evolutek/carte-mat-de-balise/V3/Board.pdf

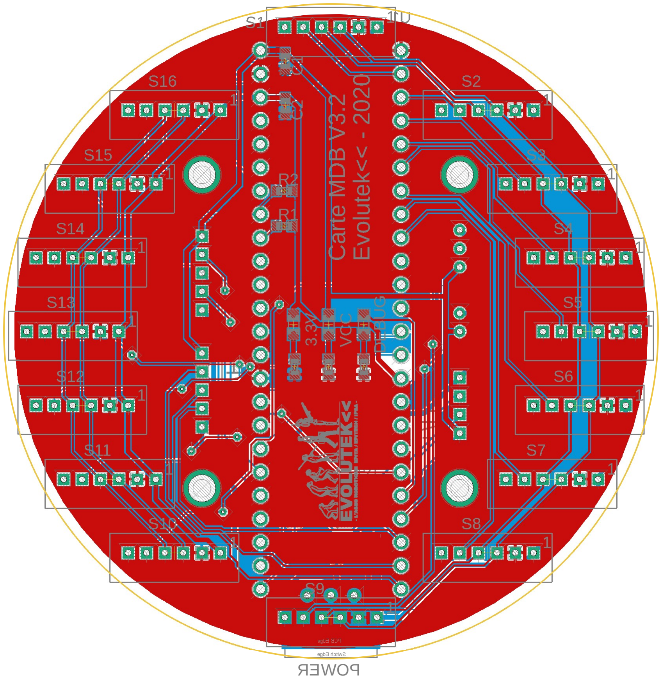
[picture p1: figure]

03/09/2020 21:59 C:\Users\coren\Documents\carte-mat-de-balise\V3\Board.brd
