evolutek/carte-mat-de-balise/V5/Mapping STM32.PNG

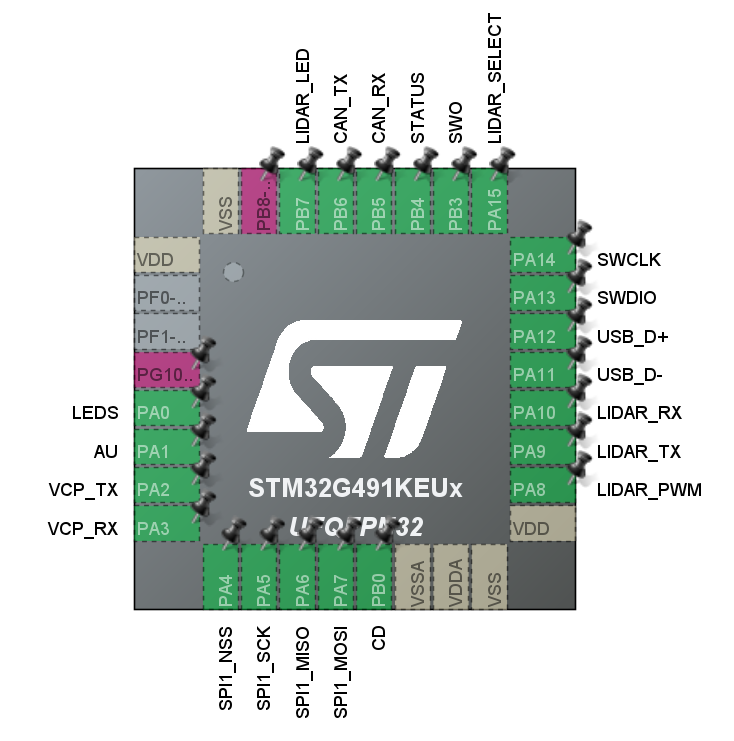
V5/Mapping STM32.PNG
