evolutek/carte-mat-de-balise/Carte Led V1/Output/carte-led.step

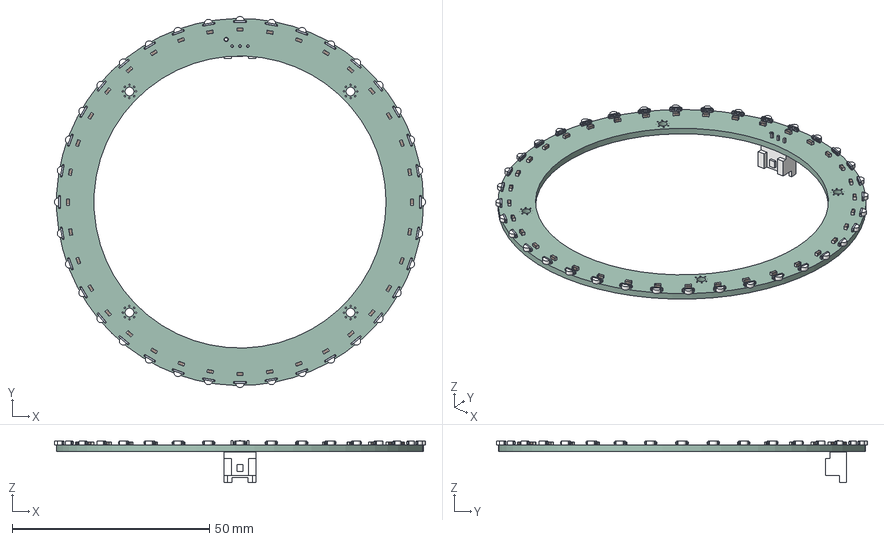
[picture p3: CAD file, 2024-11-06]
Carte Led V1/Output/carte-led.step
94.0 x 94.0 x 10.7 mm
_autosave-carte-led PCB
