evolutek/carte-mat-de-balise/V2/Board.step

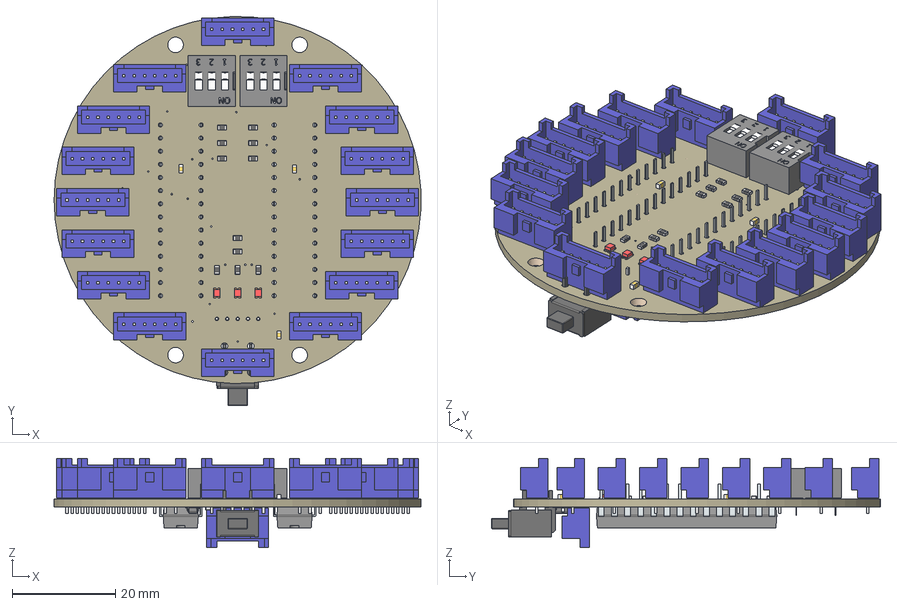
[picture p4: CAD file, 2020-03-29, an earlier design]
V2/Board.step
70.9 x 75.2 x 17.3 mm
Board
CHIPLED_0805 x 3
10k x 12
JST6 x 16
JST5
EDG-03 x 2
PinsArrayLR x 2
100nF x 3
FDV303N
