evolutek/carte-mat-de-balise/(threads)

Thread 6 (2024-12-05):

Développement SW

TheCrabe, 2024-12-05:
- [x] Send request
- [x] Read Descriptor (polling)
- [ ] Read Descriptor (interrupt)
- [ ] Read Descriptor (DMA)
- [ ] Continuous scan reading (polling)
- [ ] Continuous scan reading (interrupt)
- [ ] Continuous scan reading (DMA)

TheCrabe, 2025-02-13:
Polling does not working with this use case

Closed 2025-04-12.
