evolutek/carte-mat-de-balise/V5/Output/Schematics.pdf

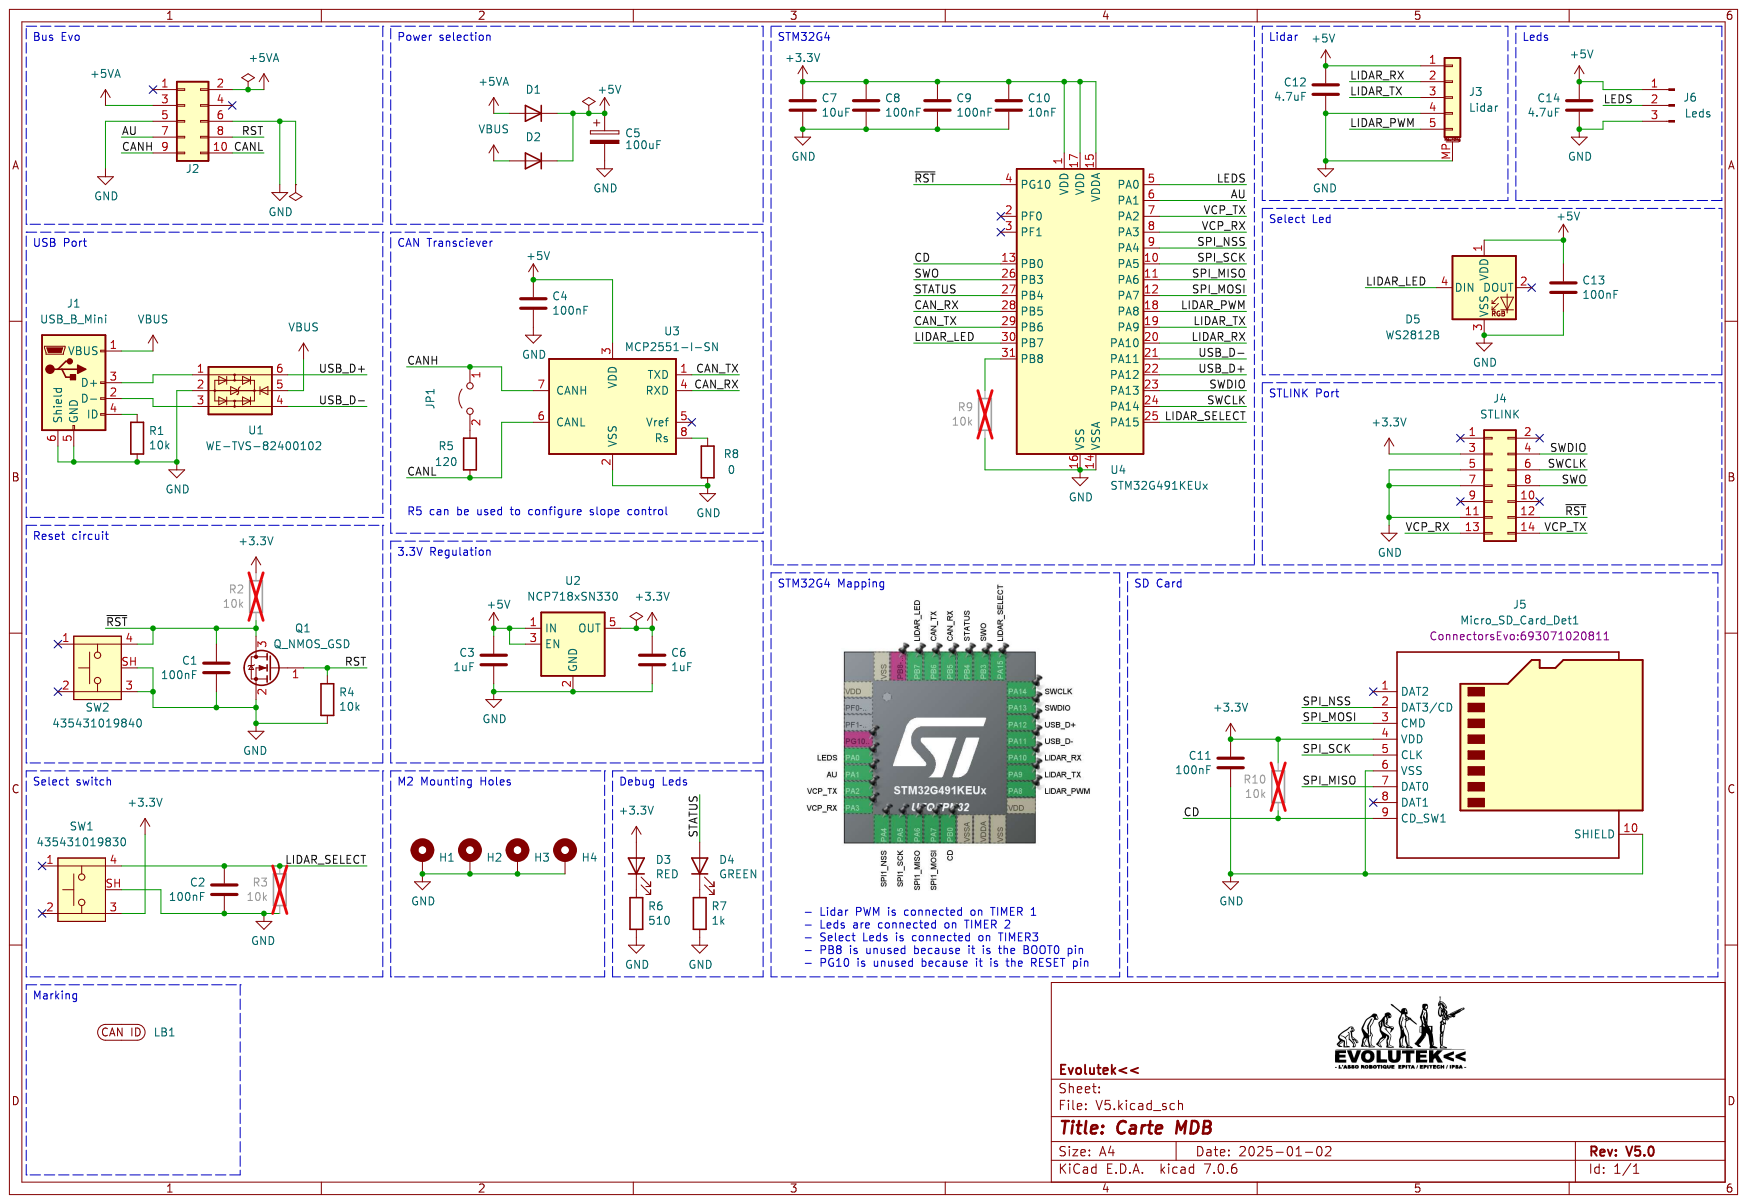
[picture p5: page 1]
