evolutek/carte-mat-de-balise/V5/Output/Board-Front.pdf

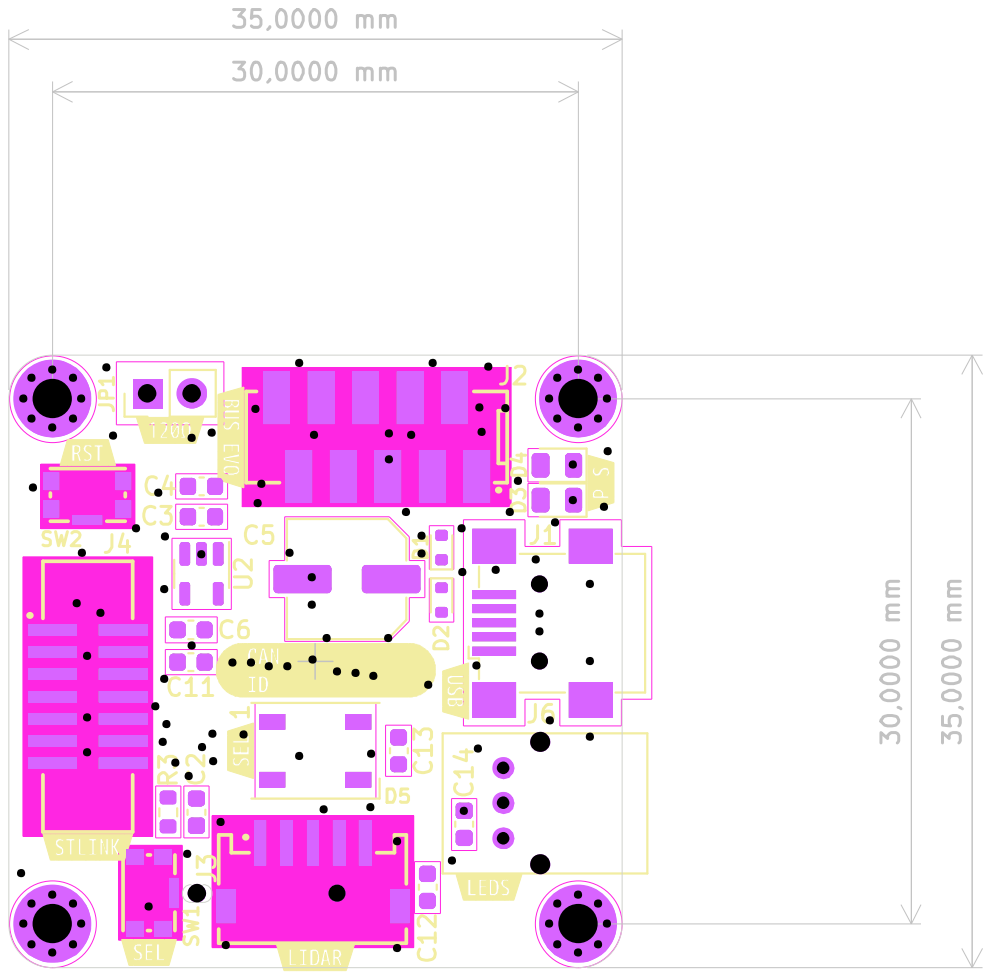
[picture p6: page 1]
