evolutek/carte-mat-de-balise/V5/Output/Board-Back.pdf

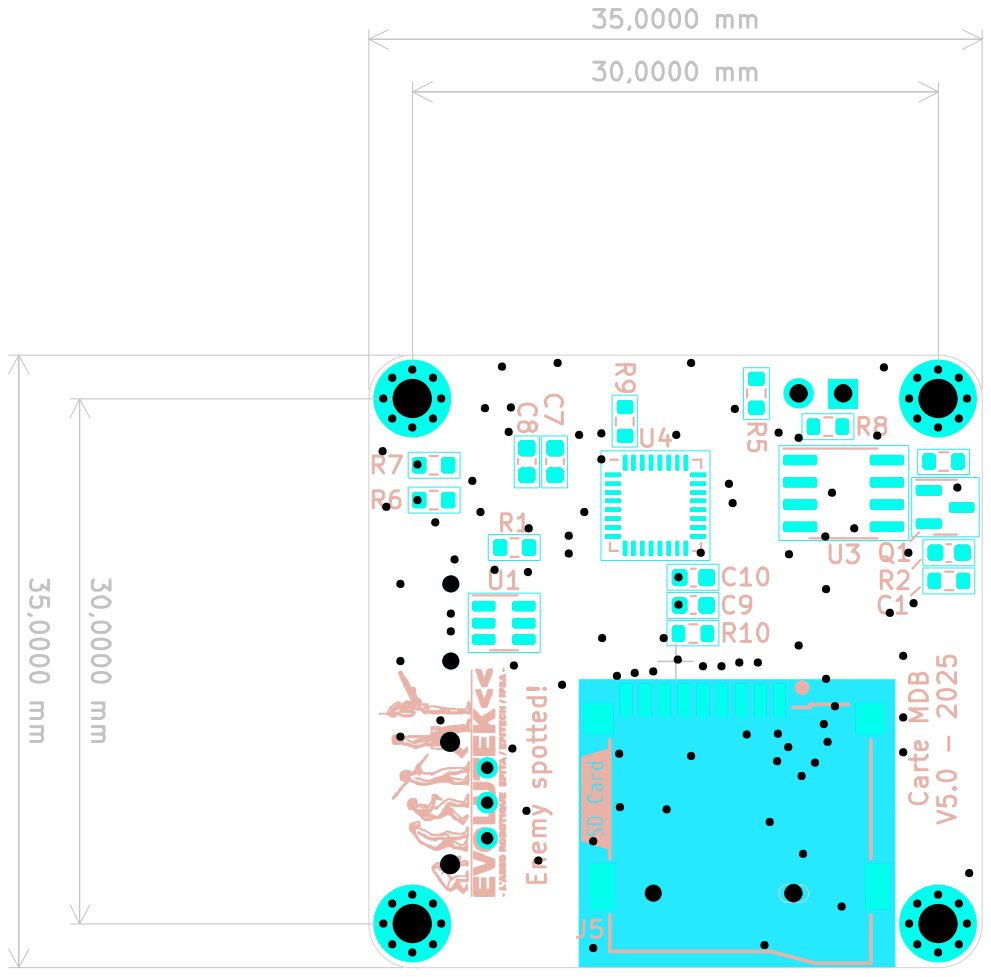
[picture p7: page 1]
