evolutek/carte-mat-de-balise/V3/Schematics.pdf

03/09/2020 21:59 C:\Users\coren\Documents\carte-mat-de-balise\V3\Board.sch (Sheet: 1/1) | JST6 GND | JST6 GND | JST6 GND | JST6 GND JST6 GND | JST6 GND | JST6 GND | JST6 GND JST6 GND | JST6 GND | JST6 GND | JST6 GND JST6 GND | JST6 GND | JST6 GND | JST6 GND

+3V34.7k

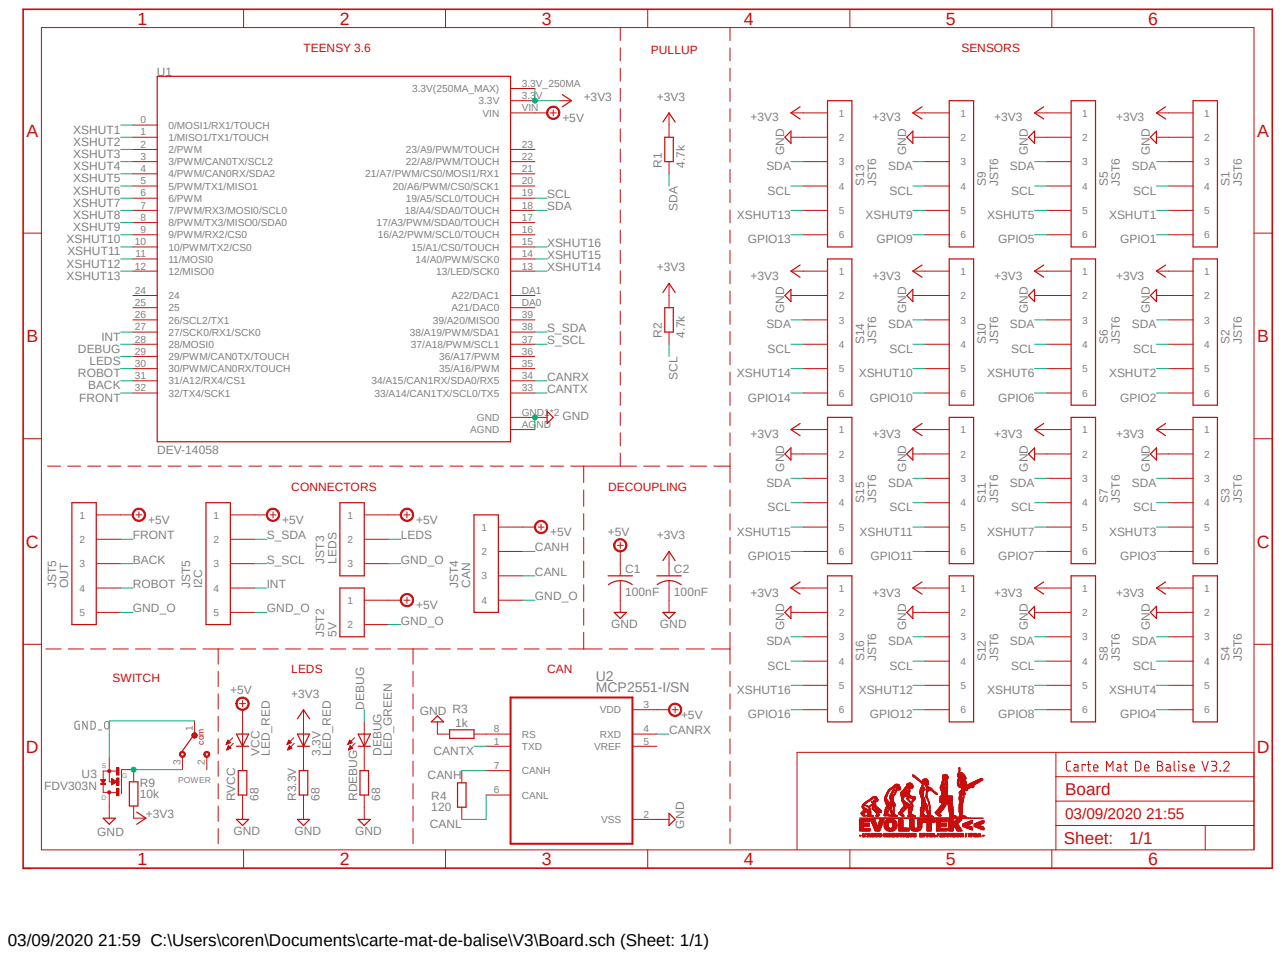
[picture p8: page 1]
