evolutek/carte-mat-de-balise/V2/Schematics.pdf

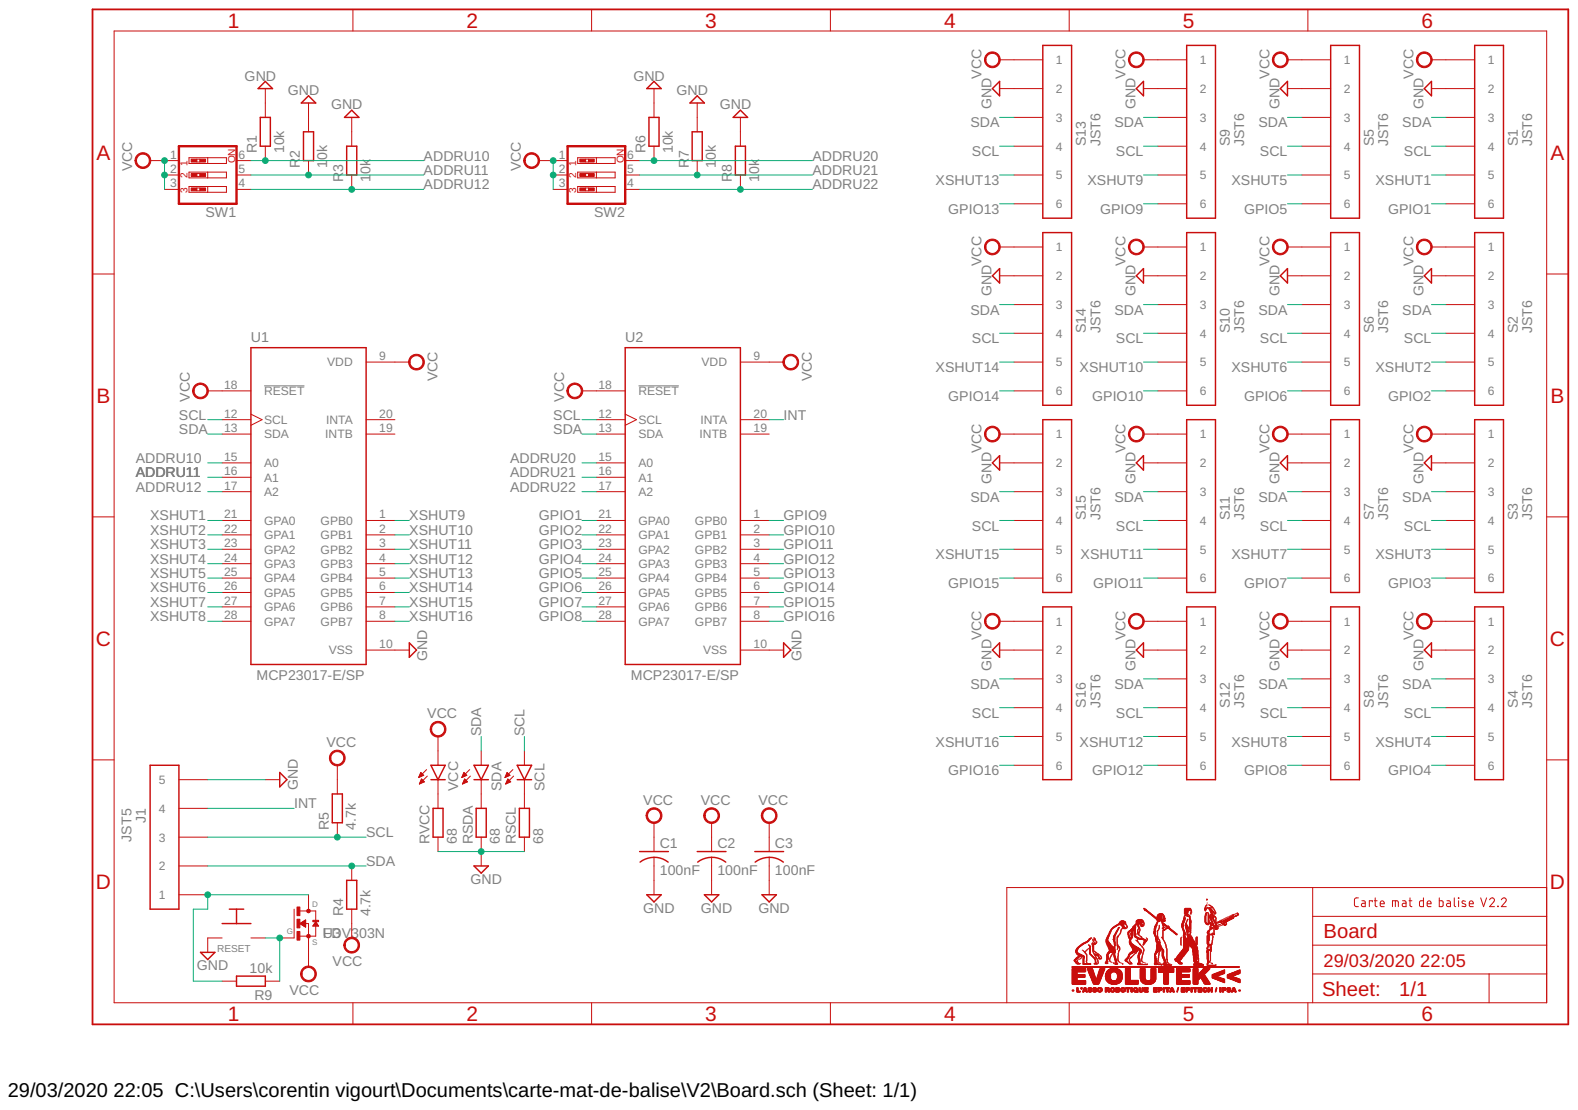
[picture p9: page 1]

VCC VCC

29/03/2020 22:05 C:\Users\corentin vigourt\Documents\carte-mat-de-balise\V2\Board.sch (Sheet: 1/1)
