evolutek/carte-mat-de-balise/Carte Led V1/Output/Schematics.pdf

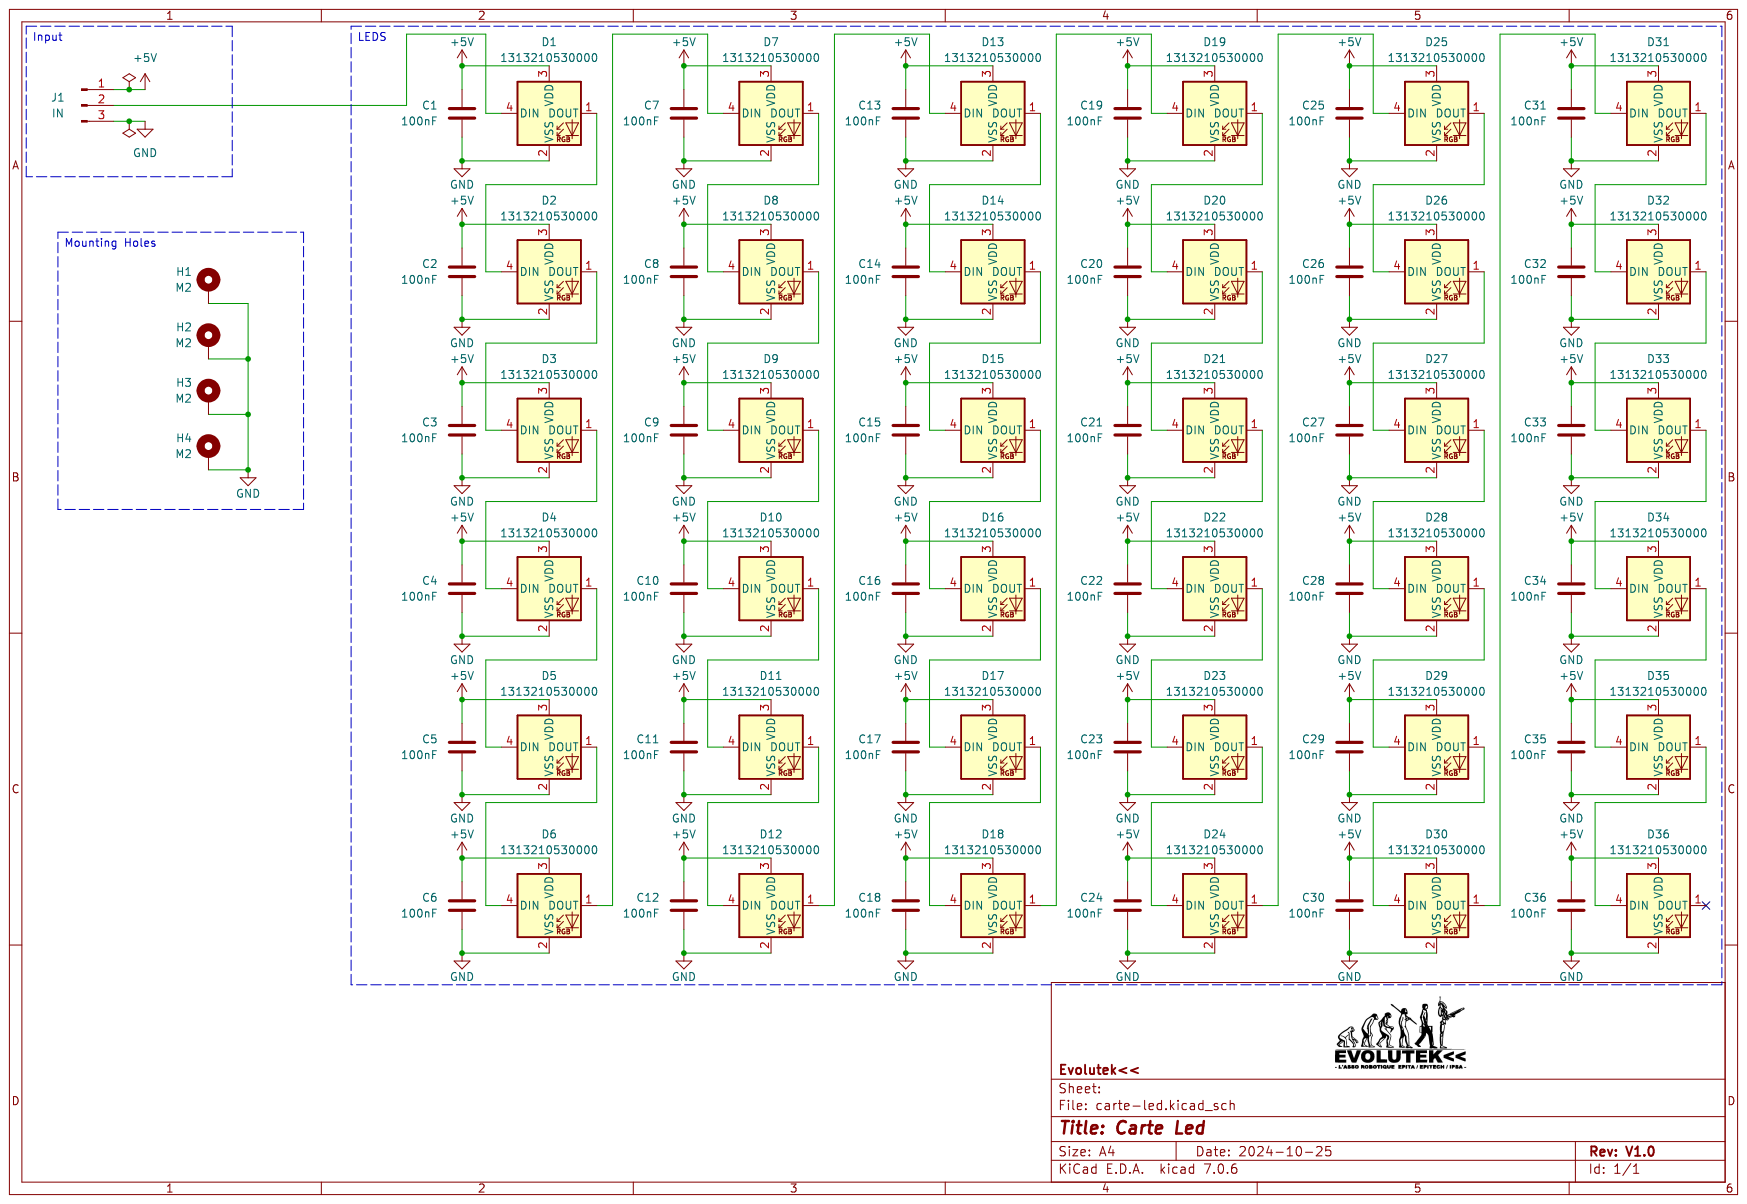
[picture p10: page 1]
