evolutek/carte-mat-de-balise/V4/Output/Schematics.pdf

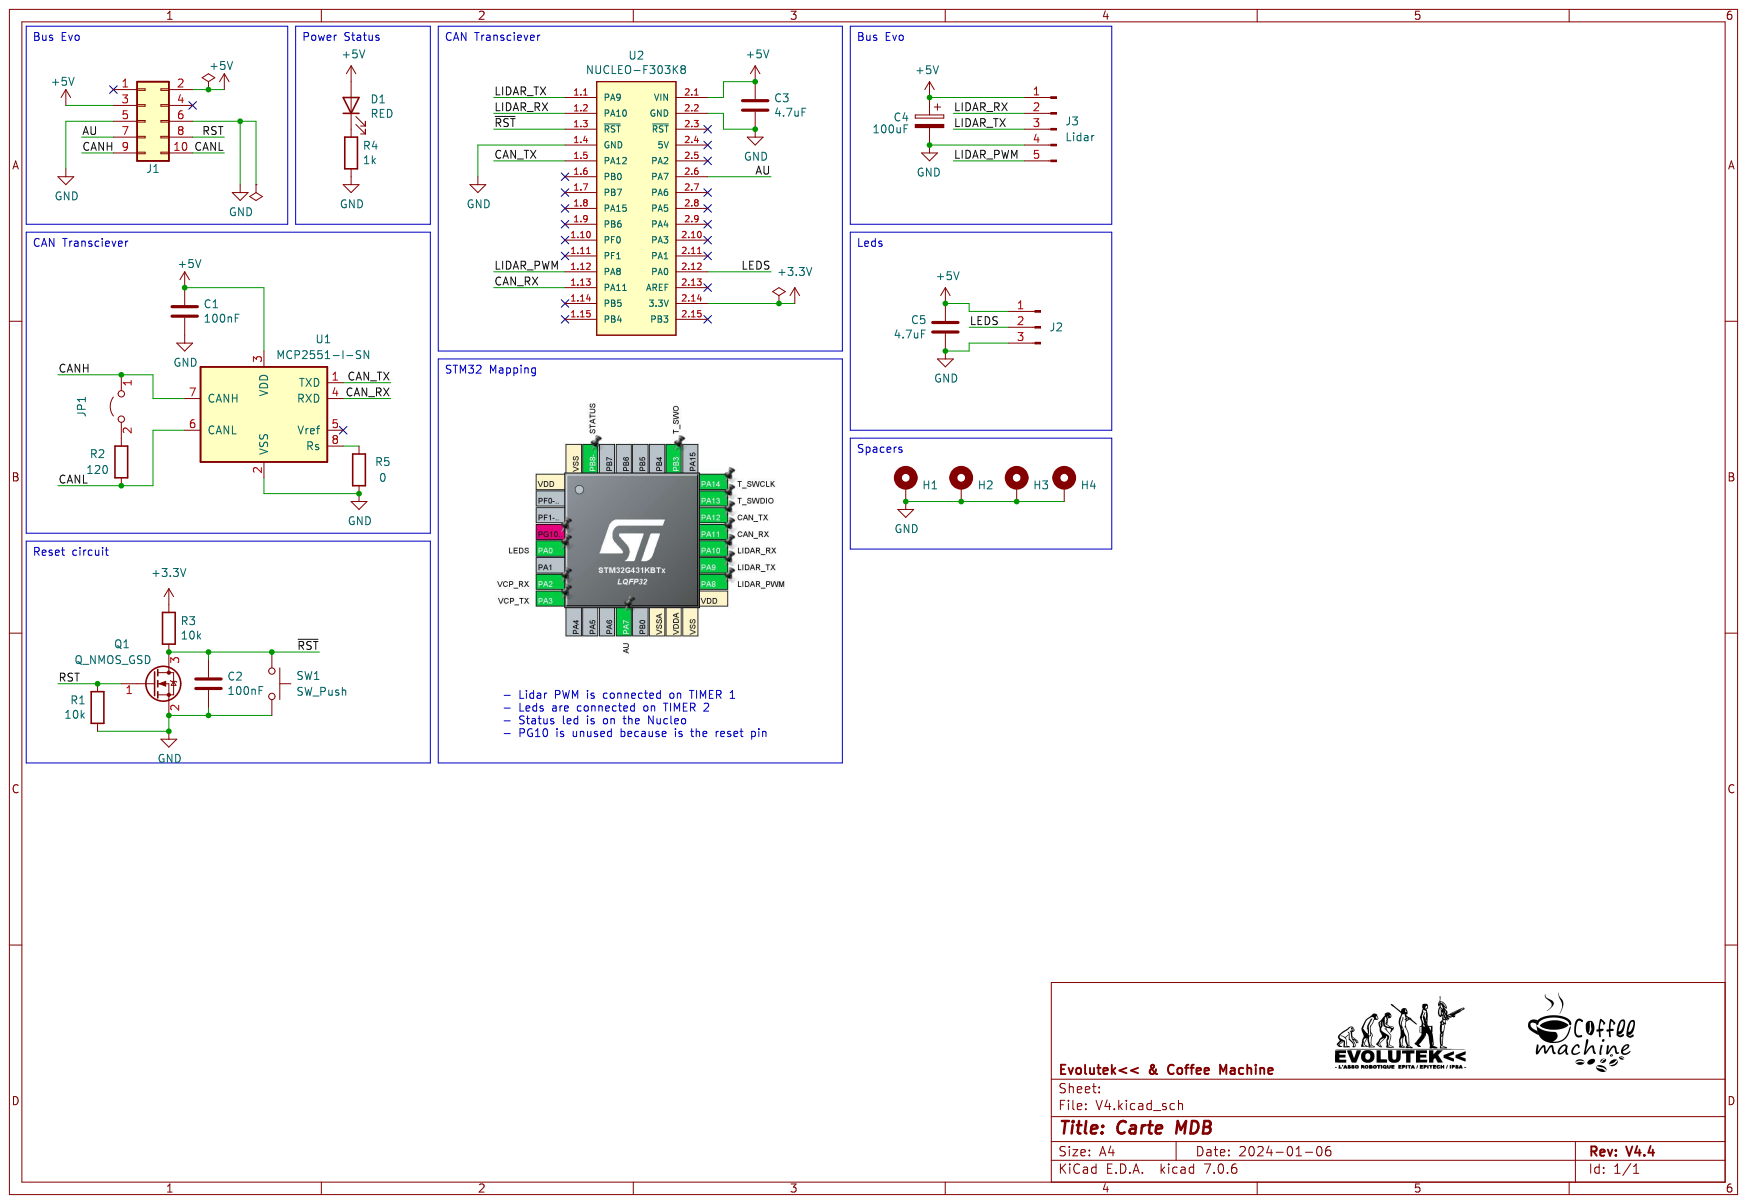
[picture p11: page 1]
