evolutek/carte-mat-de-balise/Carte Led V1/Output/Board-Front.pdf

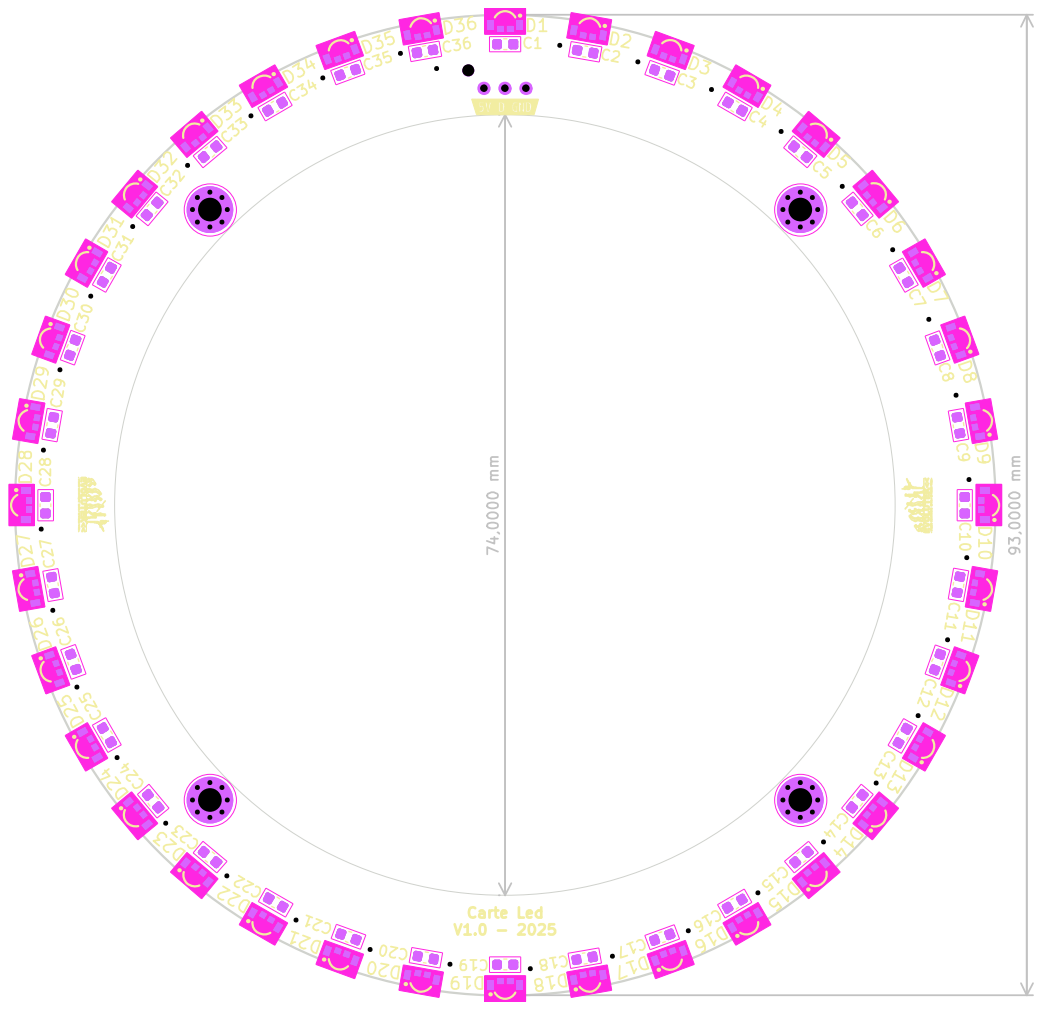
[picture p12: page 1]
