evolutek/carte-mat-de-balise/V4/Output/Board-Back.pdf

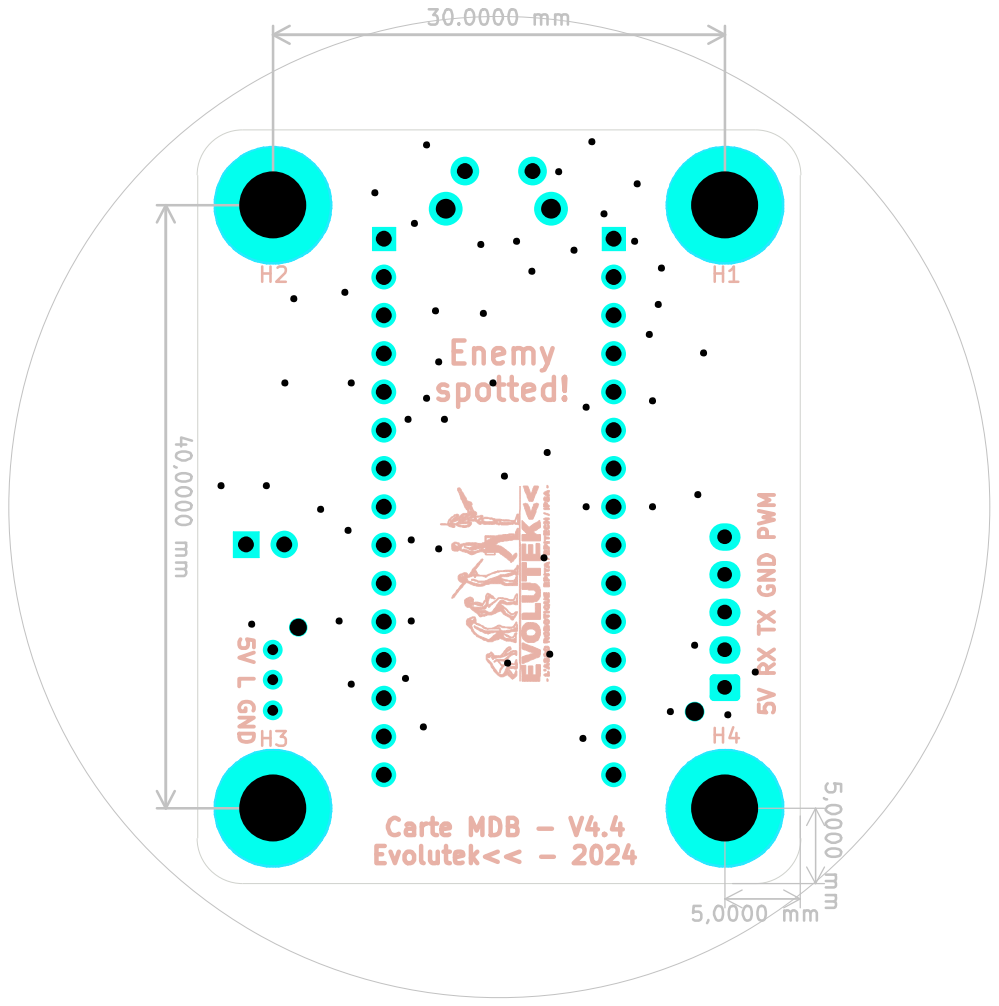
[picture p13: page 1]
