evolutek/carte-mat-de-balise/V4/Output/Board-Front.pdf

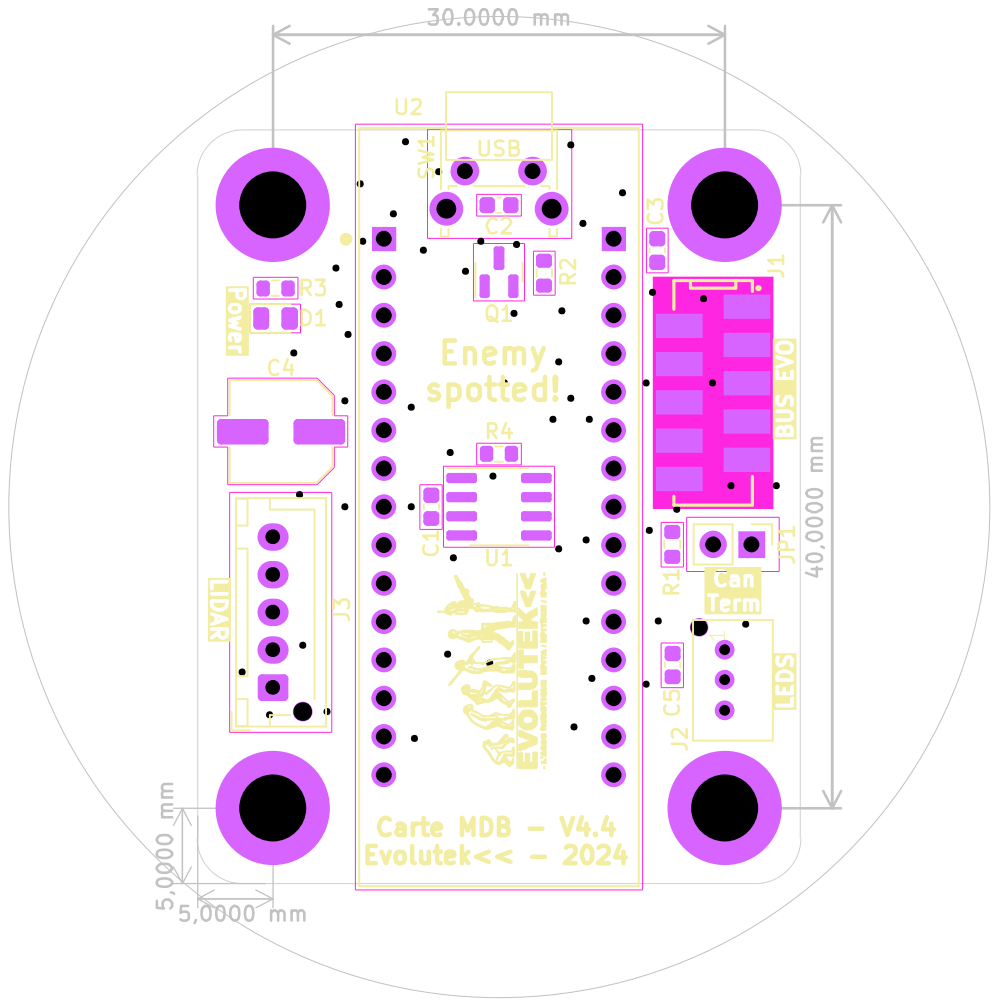
[picture p14: page 1]
