evolutek/carte-mat-de-balise/V5/V5.kicad_pcb

## KiCad design V5/V5.kicad_pcb (2025-03-05)

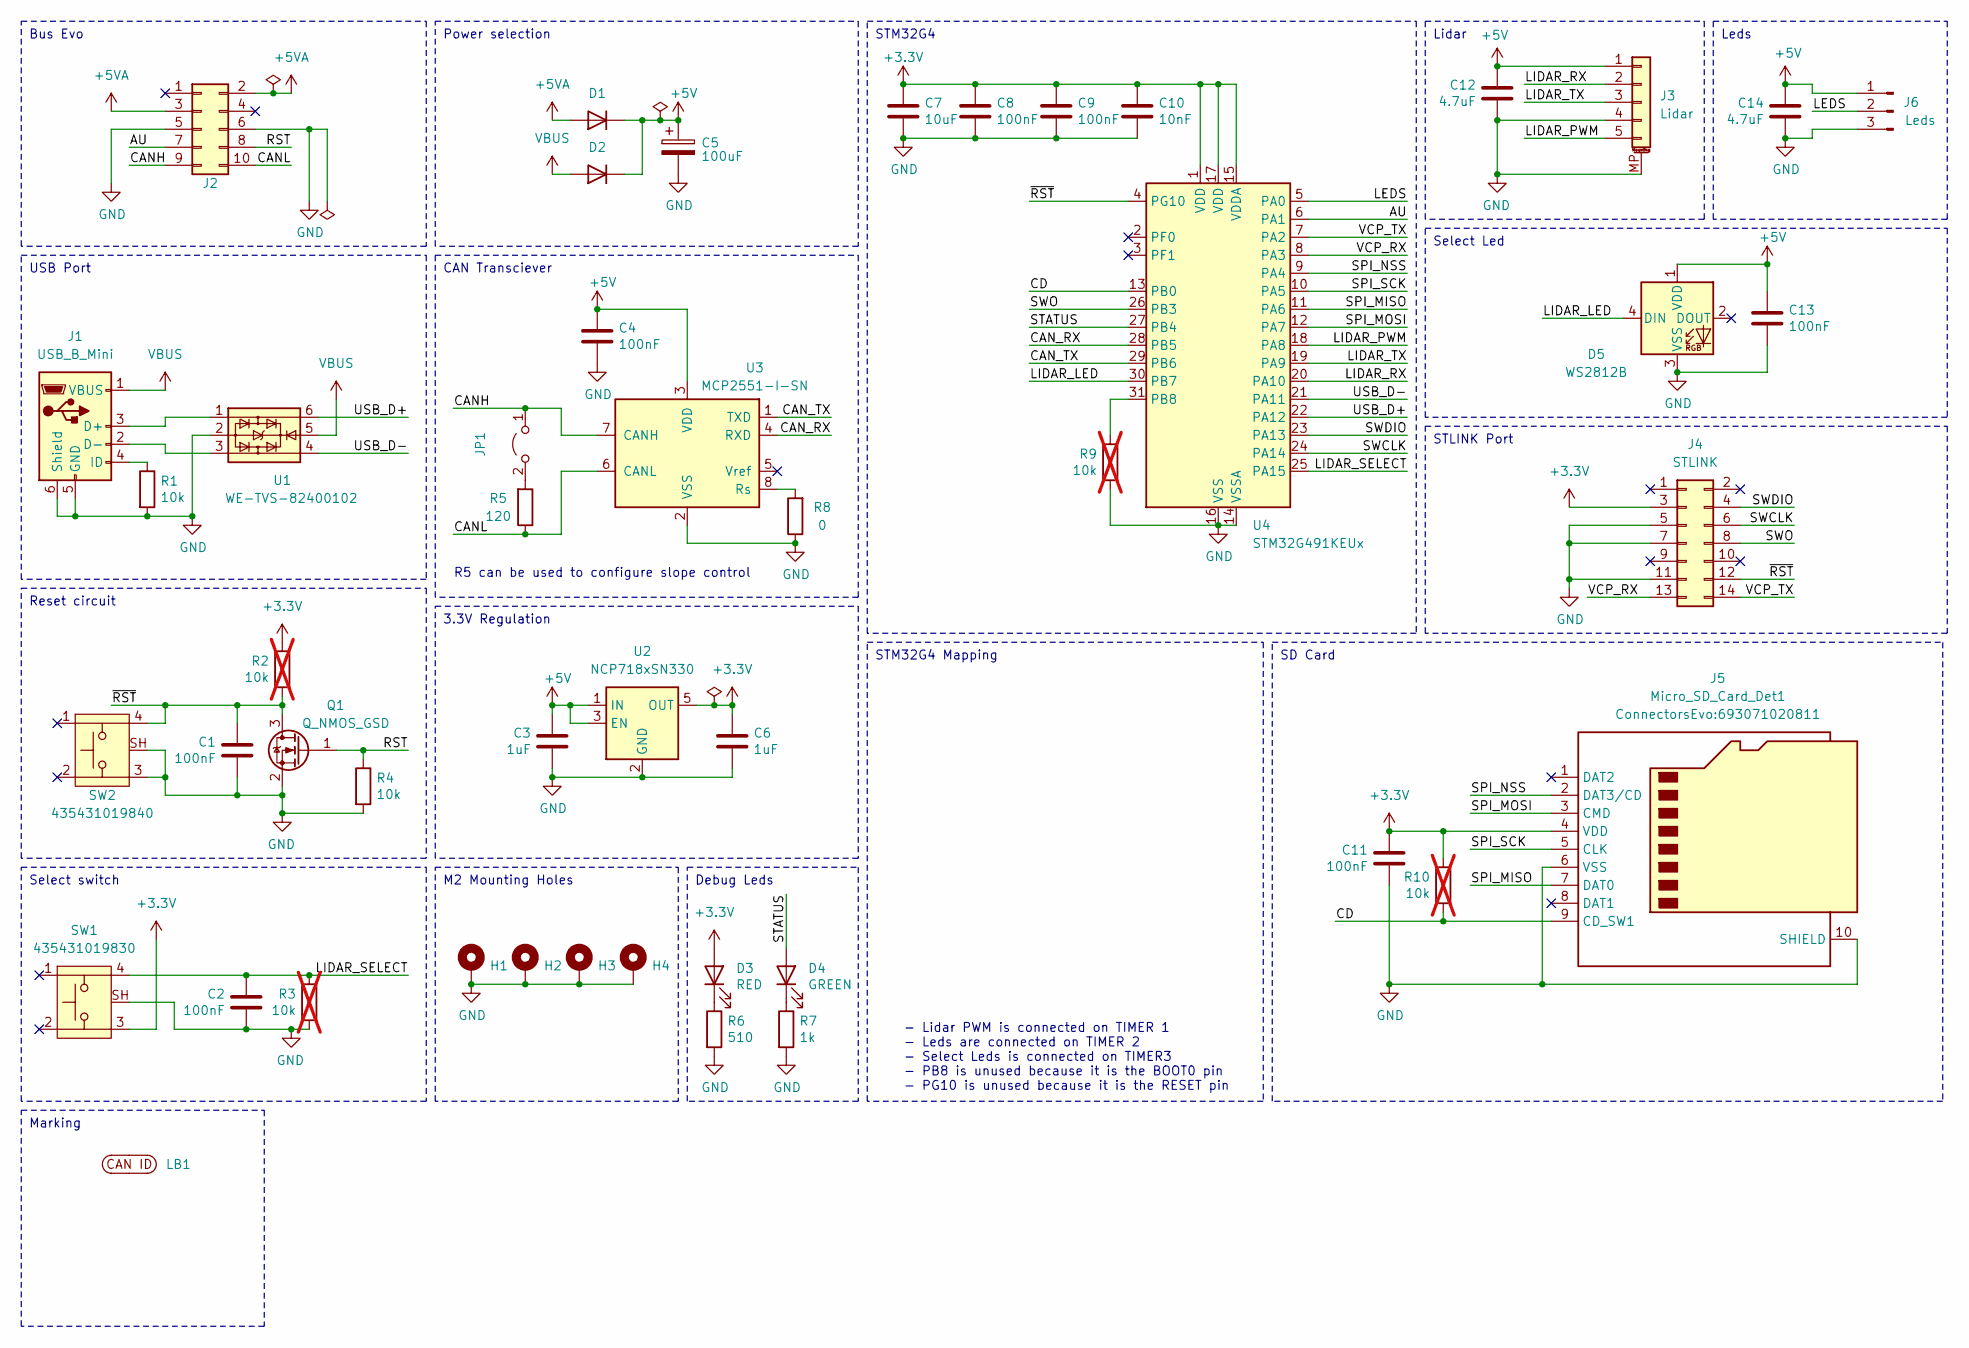
[picture p15: schematic V5.kicad_sch, Carte MDB]

Parts:
C1, C2, C4, C8, C9, C11, C13: 100nF; C_0603_1608Metric
C3, C6: 1uF; C_0603_1608Metric
C5: 100uF; C_Elec_6.3x7.7
C7: 10uF; C_0603_1608Metric
C10: 10nF; C_0603_1608Metric
C12, C14: 4.7uF; C_0603_1608Metric
D1, D2: D; D_SOD-523
D3: RED; LED_0805_2012Metric
D4: GREEN; LED_0805_2012Metric
D5: WS2812B; LED_WS2812B_PLCC4_5.0x5.0mm_P3.2mm
H1, H2, H3, H4: MountingHole_Pad; MountingHole_2.2mm_M2_Pad_Via
J1: USB_B_Mini; USB_Mini-B_Wuerth_65100516121_Horizontal
J2: Conn_02x05_Odd_Even; 690367281076
J3: Lidar; 648105131822
J4: STLINK; 62701420621
J5: Micro_SD_Card_Det1; 693071020811
J6: Leds; S03B-PASK
JP1: Jumper_2_Open; PinHeader_1x02_P2.54mm_Vertical
LB1: CAN ID lablel
Q1: Q_NMOS_GSD; SOT-23
R1, R4: 10k; R_0603_1608Metric
R2, R3, R9, R10: 10k; R_0603_1608Metric; not fitted
R5: 120; R_0603_1608Metric
R6: 510; R_0603_1608Metric
R7: 1k; R_0603_1608Metric
R8: 0; R_0603_1608Metric
SW1: 435431019830
SW2: 435431019840
U1: WE-TVS-82400102; SOT-23-6
U2: NCP718xSN330; SOT-23-5
U3: MCP2551-I-SN; SOIC-8_3.9x4.9mm_P1.27mm
U4: STM32G491KEUx; QFN-32-1EP_5x5mm_P0.5mm_EP3.45x3.45mm-Without thermal pad

Connections:
+3.3V: C6.1, C7.1, C8.1, C9.1, C10.1, C11.1, D3.2 (A), J4.3, J5.4 (VDD), R2.1, R10.1, SW1.3, U2.5 (OUT), U4.1 (VDD), U4.15 (VDDA), U4.17 (VDD)
+5V: C3.1, C4.1, C5.1, C12.1, C13.1, C14.1, D1.1 (K), D2.1 (K), D5.1 (VDD), J3.1, J6.1, U2.1 (IN), U2.3 (EN), U3.3 (VDD)
+5VA: D1.2 (A), J2.2, J2.3
/AU: J2.7, U4.6 (PA1)
/CANH: J2.9, JP1.1 (A), U3.7 (CANH)
/CANL: J2.10, R5.1, U3.6 (CANL)
/CAN_RX: U3.4 (RXD), U4.28 (PB5)
/CAN_TX: U3.1 (TXD), U4.29 (PB6)
/CD: J5.9 (CD_SW1), R10.2, U4.13 (PB0)
/LEDS: J6.2, U4.5 (PA0)
/LIDAR_LED: D5.4 (DIN), U4.30 (PB7)
/LIDAR_PWM: J3.5, U4.18 (PA8)
/LIDAR_RX: J3.2, U4.20 (PA10)
/LIDAR_SELECT: C2.1, R3.1, SW1.4, U4.25 (PA15)
/LIDAR_TX: J3.3, U4.19 (PA9)
/RST: J2.8, Q1.1 (G), R4.1
/SPI_MISO: J5.7 (DAT0), U4.11 (PA6)
/SPI_MOSI: J5.3 (CMD), U4.12 (PA7)
/SPI_NSS: J5.2 (DAT3/CD), U4.9 (PA4)
/SPI_SCK: J5.5 (CLK), U4.10 (PA5)
/STATUS: D4.2 (A), U4.27 (PB4)
/SWCLK: J4.6, U4.24 (PA14)
/SWDIO: J4.4, U4.23 (PA13)
/SWO: J4.8, U4.26 (PB3)
/USB_D+: U1.6, U4.22 (PA12)
/USB_D-: U1.4, U4.21 (PA11)
/VCP_RX: J4.13, U4.8 (PA3)
/VCP_TX: J4.14, U4.7 (PA2)
/~RST: C1.1, J4.12, Q1.3 (D), R2.2, SW2.4, U4.4 (PG10)
GND: C1.2, C2.2, C3.2, C4.2, C5.2, C6.2, C7.2, C8.2, C9.2, C10.2, C11.2, C12.2, C13.2, C14.2, D5.3 (VSS), H1.1, H2.1, H3.1, H4.1, J1.5 (GND), J1.6 (Shield), J2.5, J2.6, J3.4, J3.MP (MountPin), J4.5, J4.7, J4.11, J5.6 (VSS), J5.10 (SHIELD), J5.11 (SHIELD), J5.12 (SHIELD), J5.13 (SHIELD), J6.3, Q1.2 (S), R1.2, R3.2, R4.2, R6.2, R7.2, R8.1, R9.2, SW1.SH, SW2.3, SW2.SH, U1.2, U2.2 (GND), U3.2 (VSS), U4.14 (VSSA), U4.16 (VSS), U4.32 (VSS)
unnamed: D3.1 (K), R6.1
unnamed: D4.1 (K), R7.1
unnamed: J1.3 (D+), U1.1
unnamed: J1.2 (D-), U1.3
unnamed: J1.4 (ID), R1.1
unnamed: JP1.2 (B), R5.2
unnamed: R8.2, U3.8 (Rs)
unnamed: R9.1, U4.31 (PB8)
VBUS: D2.2 (A), J1.1 (VBUS), U1.5

Notes on the sheet:
Select Led
USB Port
CAN Transciever
Power selection
3.3V Regulation
Lidar
Leds
M2 Mounting Holes
STM32G4
Reset circuit
Select switch
SD Card
Debug Leds
Marking
Bus Evo
STLINK Port
STM32G4 Mapping
R5 can be used to configure slope control
- Lidar PWM is connected on TIMER 1 - Leds are connected on TIMER 2 - Select Leds is connected on TIMER3 - PB8 is unused because it is the BOOT0 pin - PG10 is unused because it is the RESET pin

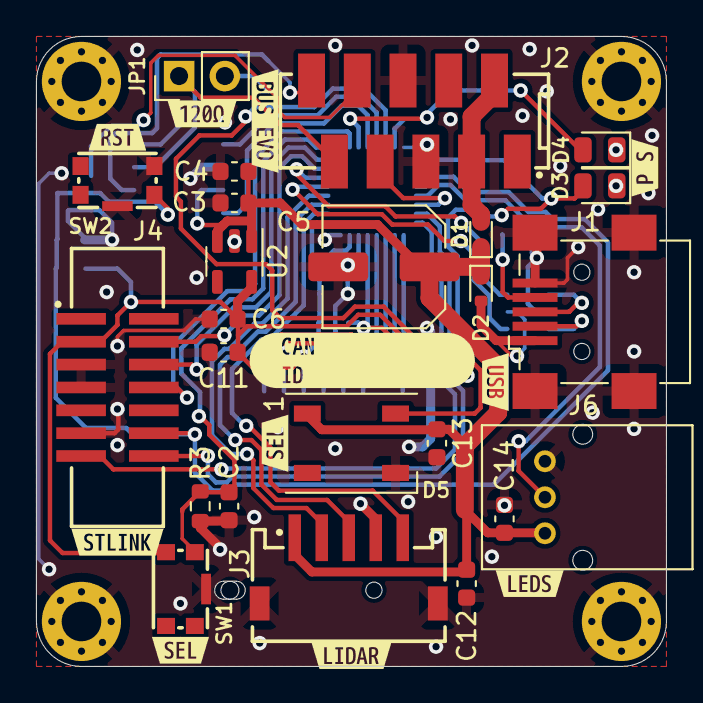
[picture p16: board V5.kicad_pcb from above]

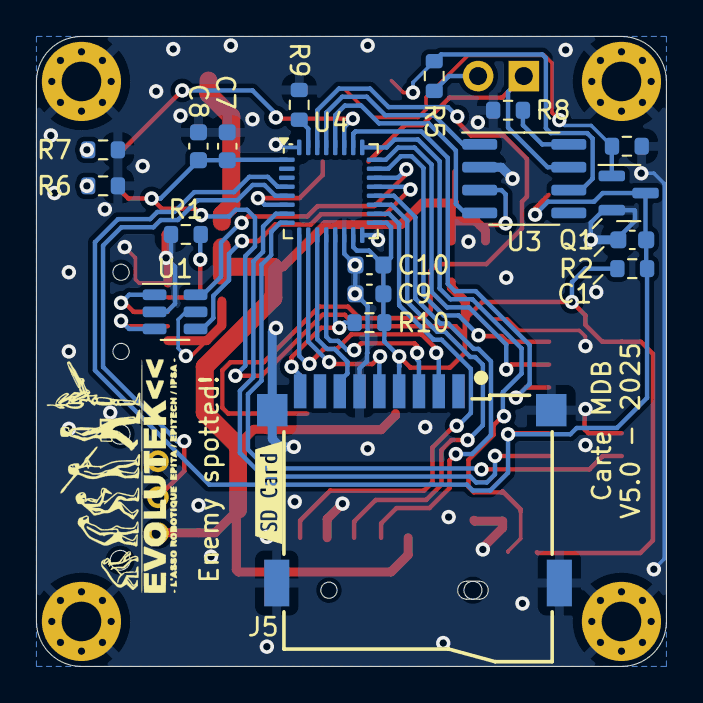
[picture p17: board V5.kicad_pcb from below]

Board: 2 copper layers, 35.0 x 35.0 mm, 59 parts (20 on the bottom side), 39 nets.

Other parts of the board:
kibuzzard-672938AE: G***; kibuzzard-672938AE
kibuzzard-672938F5: G***; kibuzzard-672938F5
kibuzzard-672939DE: G***; kibuzzard-672939DE
kibuzzard-672956A1: G***; kibuzzard-672956A1
kibuzzard-6729394F: G***; kibuzzard-6729394F
kibuzzard-67293773: G***; kibuzzard-67293773
kibuzzard-67293797: G***; kibuzzard-67293797
kibuzzard-67293826: G***; kibuzzard-67293826
kibuzzard-67293839: G***; kibuzzard-67293839
kibuzzard-67293907: G***; kibuzzard-67293907
kibuzzard-67293975: G***; kibuzzard-67293975
