evolutek/carte-mat-de-balise/Carte Led V1/carte-led.kicad_pcb

## KiCad design Carte Led V1/carte-led.kicad_pcb (2024-11-06)

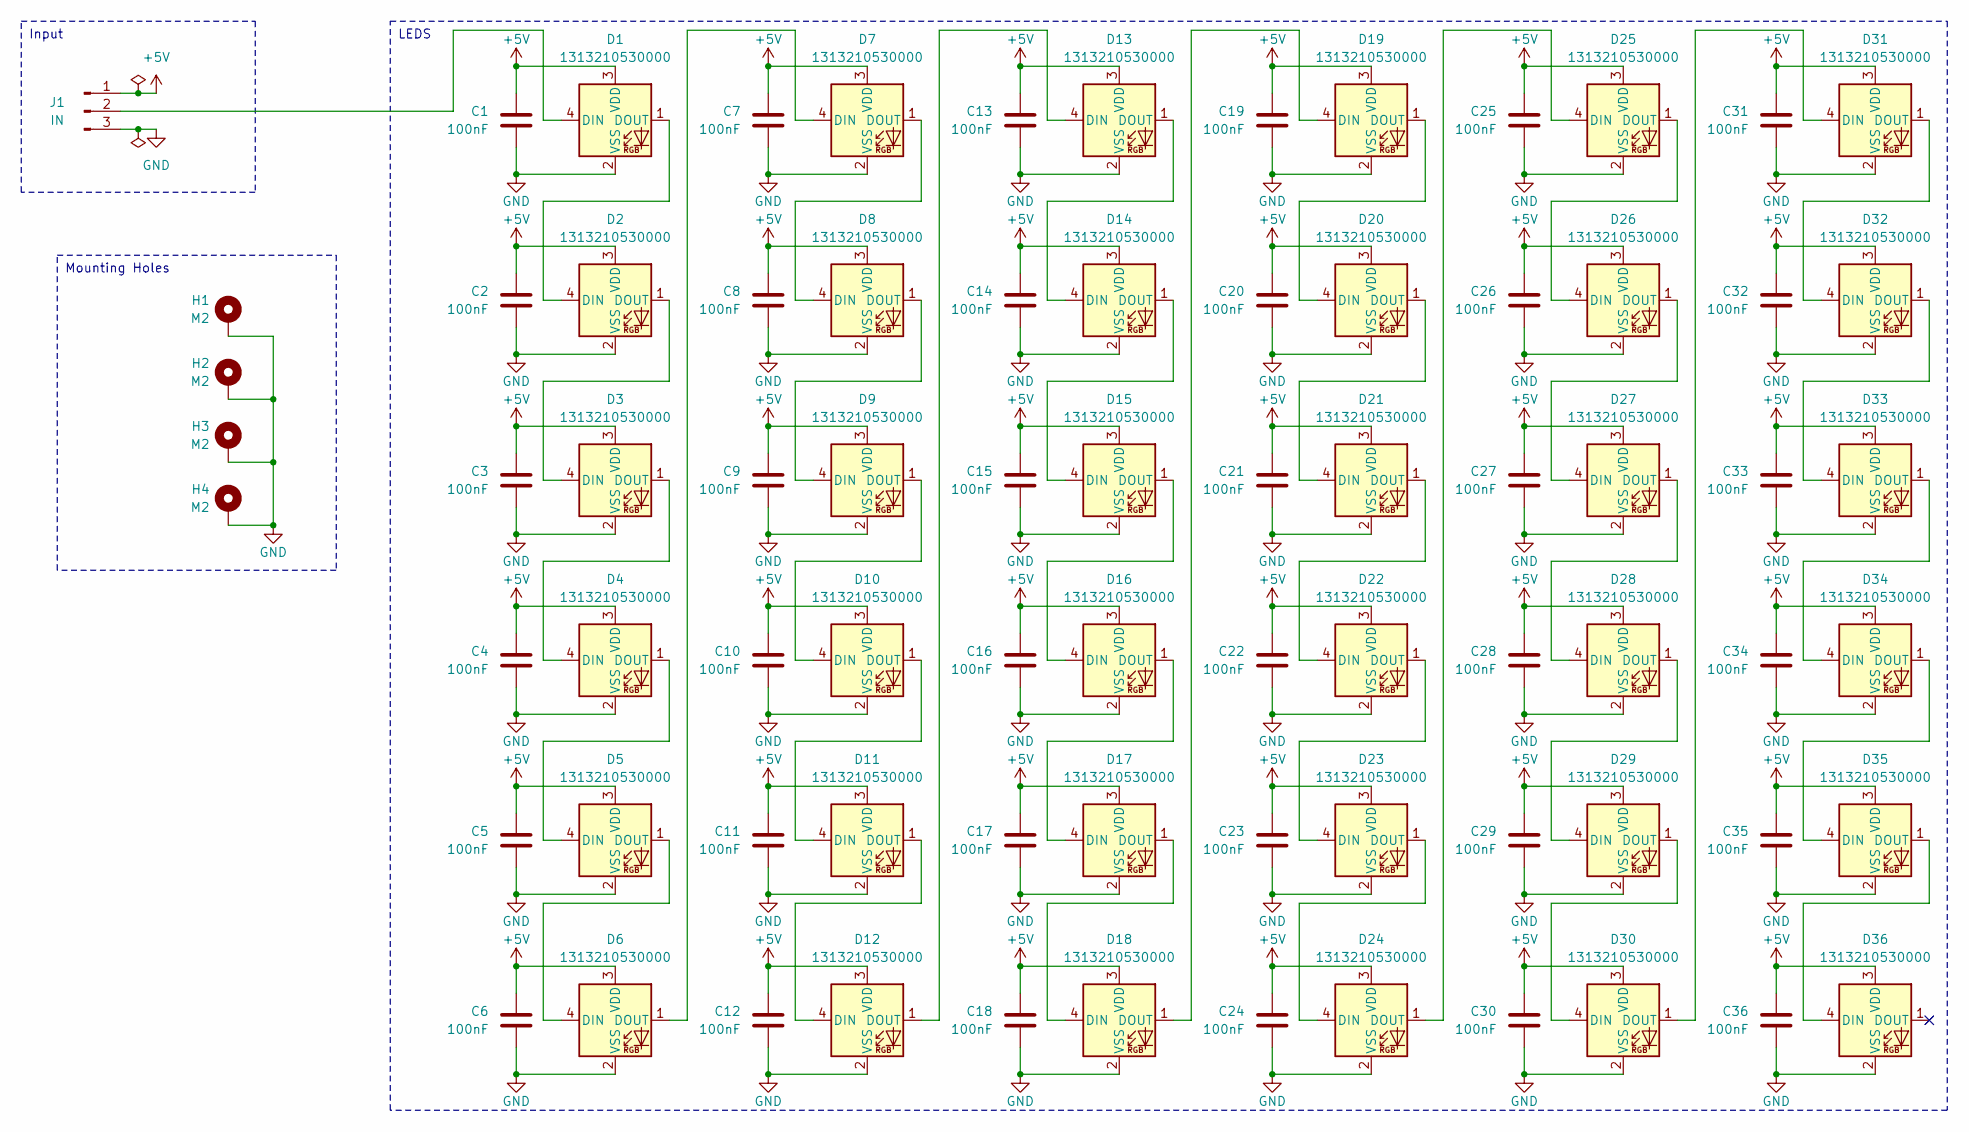
[picture p18: schematic carte-led.kicad_sch, Carte Led]

Parts:
C1, C2, C3, C4, C5, C6, C7, C8, C9, C10, C11, C12, C13, C14, C15, C16, C17, C18, C19, C20, C21, C22, C23, C24, C25, C26, C27, C28, C29, C30, C31, C32, C33, C34, C35, C36: 100nF; C_0603_1608Metric
D1, D2, D3, D4, D5, D6, D7, D8, D9, D10, D11, D12, D13, D14, D15, D16, D17, D18, D19, D20, D21, D22, D23, D24, D25, D26, D27, D28, D29, D30, D31, D32, D33, D34, D35, D36: 1313210530000
H1, H2, H3, H4: M2; MountingHole_2.2mm_M2_Pad_Via
J1: IN; B03B-PASK

Connections:
+5V: C1.1, C2.1, C3.1, C4.1, C5.1, C6.1, C7.1, C8.1, C9.1, C10.1, C11.1, C12.1, C13.1, C14.1, C15.1, C16.1, C17.1, C18.1, C19.1, C20.1, C21.1, C22.1, C23.1, C24.1, C25.1, C26.1, C27.1, C28.1, C29.1, C30.1, C31.1, C32.1, C33.1, C34.1, C35.1, C36.1, D1.3 (VDD), D2.3 (VDD), D3.3 (VDD), D4.3 (VDD), D5.3 (VDD), D6.3 (VDD), D7.3 (VDD), D8.3 (VDD), D9.3 (VDD), D10.3 (VDD), D11.3 (VDD), D12.3 (VDD), D13.3 (VDD), D14.3 (VDD), D15.3 (VDD), D16.3 (VDD), D17.3 (VDD), D18.3 (VDD), D19.3 (VDD), D20.3 (VDD), D21.3 (VDD), D22.3 (VDD), D23.3 (VDD), D24.3 (VDD), D25.3 (VDD), D26.3 (VDD), D27.3 (VDD), D28.3 (VDD), D29.3 (VDD), D30.3 (VDD), D31.3 (VDD), D32.3 (VDD), D33.3 (VDD), D34.3 (VDD), D35.3 (VDD), D36.3 (VDD), J1.1
GND: C1.2, C2.2, C3.2, C4.2, C5.2, C6.2, C7.2, C8.2, C9.2, C10.2, C11.2, C12.2, C13.2, C14.2, C15.2, C16.2, C17.2, C18.2, C19.2, C20.2, C21.2, C22.2, C23.2, C24.2, C25.2, C26.2, C27.2, C28.2, C29.2, C30.2, C31.2, C32.2, C33.2, C34.2, C35.2, C36.2, D1.2 (VSS), D2.2 (VSS), D3.2 (VSS), D4.2 (VSS), D5.2 (VSS), D6.2 (VSS), D7.2 (VSS), D8.2 (VSS), D9.2 (VSS), D10.2 (VSS), D11.2 (VSS), D12.2 (VSS), D13.2 (VSS), D14.2 (VSS), D15.2 (VSS), D16.2 (VSS), D17.2 (VSS), D18.2 (VSS), D19.2 (VSS), D20.2 (VSS), D21.2 (VSS), D22.2 (VSS), D23.2 (VSS), D24.2 (VSS), D25.2 (VSS), D26.2 (VSS), D27.2 (VSS), D28.2 (VSS), D29.2 (VSS), D30.2 (VSS), D31.2 (VSS), D32.2 (VSS), D33.2 (VSS), D34.2 (VSS), D35.2 (VSS), D36.2 (VSS), H1.1, H2.1, H3.1, H4.1, J1.3
unnamed: D1.4 (DIN), J1.2
unnamed: D1.1 (DOUT), D2.4 (DIN)
unnamed: D2.1 (DOUT), D3.4 (DIN)
unnamed: D3.1 (DOUT), D4.4 (DIN)
unnamed: D4.1 (DOUT), D5.4 (DIN)
unnamed: D5.1 (DOUT), D6.4 (DIN)
unnamed: D6.1 (DOUT), D7.4 (DIN)
unnamed: D7.1 (DOUT), D8.4 (DIN)
unnamed: D8.1 (DOUT), D9.4 (DIN)
unnamed: D9.1 (DOUT), D10.4 (DIN)
unnamed: D10.1 (DOUT), D11.4 (DIN)
unnamed: D11.1 (DOUT), D12.4 (DIN)
unnamed: D12.1 (DOUT), D13.4 (DIN)
unnamed: D13.1 (DOUT), D14.4 (DIN)
unnamed: D14.1 (DOUT), D15.4 (DIN)
unnamed: D15.1 (DOUT), D16.4 (DIN)
unnamed: D16.1 (DOUT), D17.4 (DIN)
unnamed: D17.1 (DOUT), D18.4 (DIN)
unnamed: D18.1 (DOUT), D19.4 (DIN)
unnamed: D19.1 (DOUT), D20.4 (DIN)
unnamed: D20.1 (DOUT), D21.4 (DIN)
unnamed: D21.1 (DOUT), D22.4 (DIN)
unnamed: D22.1 (DOUT), D23.4 (DIN)
unnamed: D23.1 (DOUT), D24.4 (DIN)
unnamed: D24.1 (DOUT), D25.4 (DIN)
unnamed: D25.1 (DOUT), D26.4 (DIN)
unnamed: D26.1 (DOUT), D27.4 (DIN)
unnamed: D27.1 (DOUT), D28.4 (DIN)
unnamed: D28.1 (DOUT), D29.4 (DIN)
unnamed: D29.1 (DOUT), D30.4 (DIN)
unnamed: D30.1 (DOUT), D31.4 (DIN)
unnamed: D31.1 (DOUT), D32.4 (DIN)
unnamed: D32.1 (DOUT), D33.4 (DIN)
unnamed: D33.1 (DOUT), D34.4 (DIN)
unnamed: D34.1 (DOUT), D35.4 (DIN)
unnamed: D35.1 (DOUT), D36.4 (DIN)

Notes on the sheet:
Mounting Holes
LEDS
Input

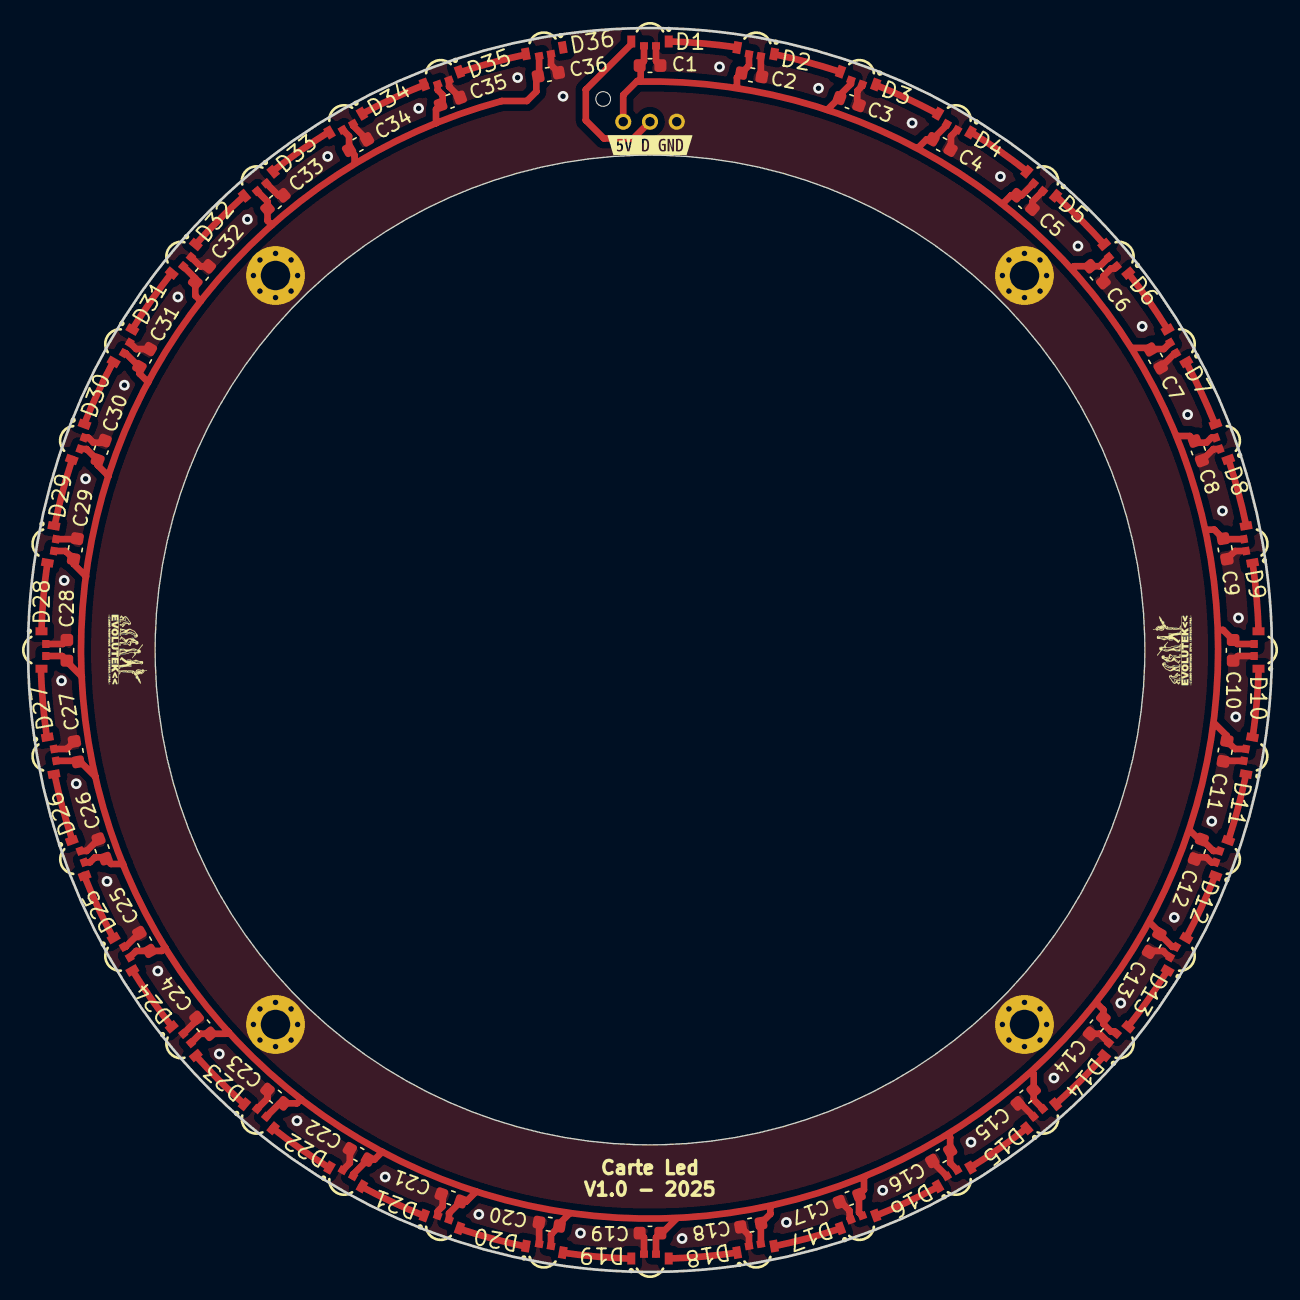
[picture p19: board carte-led.kicad_pcb from above]

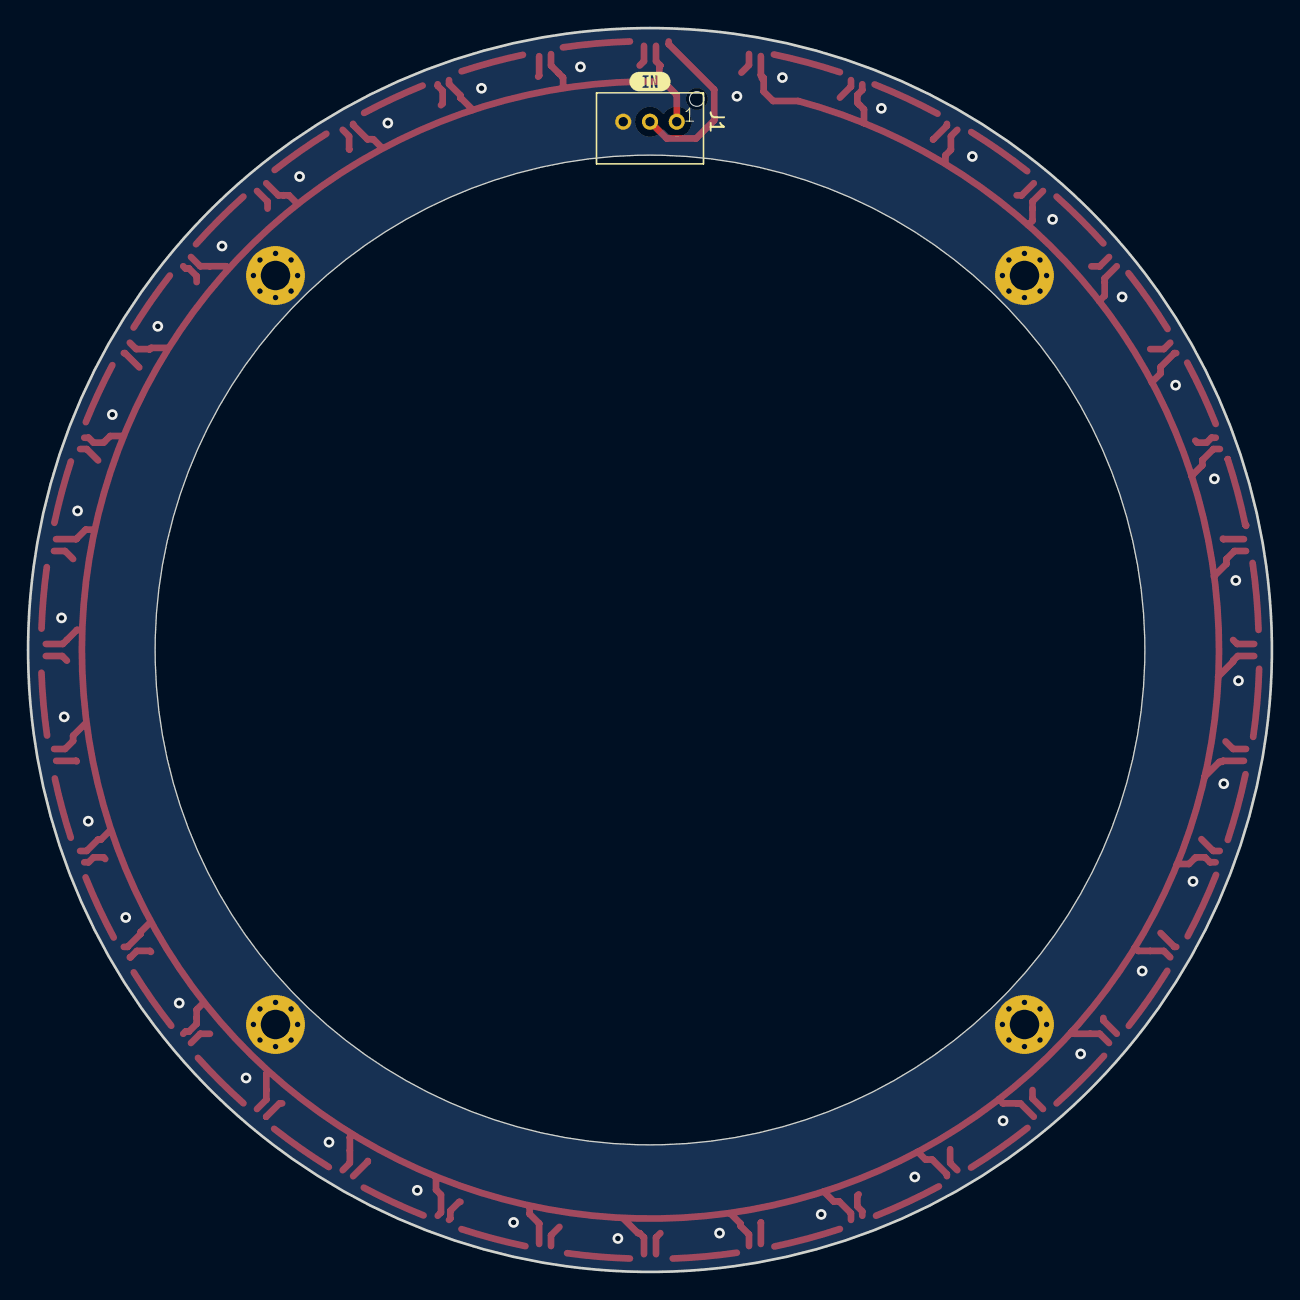
[picture p20: board carte-led.kicad_pcb from below]

Board: 2 copper layers, 93.0 x 93.0 mm, 79 parts (2 on the bottom side), 38 nets.

Other parts of the board:
kibuzzard-671BE0FE: G***; kibuzzard-671BE0FE
kibuzzard-671BE04B: G***; kibuzzard-671BE04B
