evolutek/carte-mat-de-balise/V4/V4.kicad_pcb

## KiCad design V4/V4.kicad_pcb (2024-02-21, an earlier design)

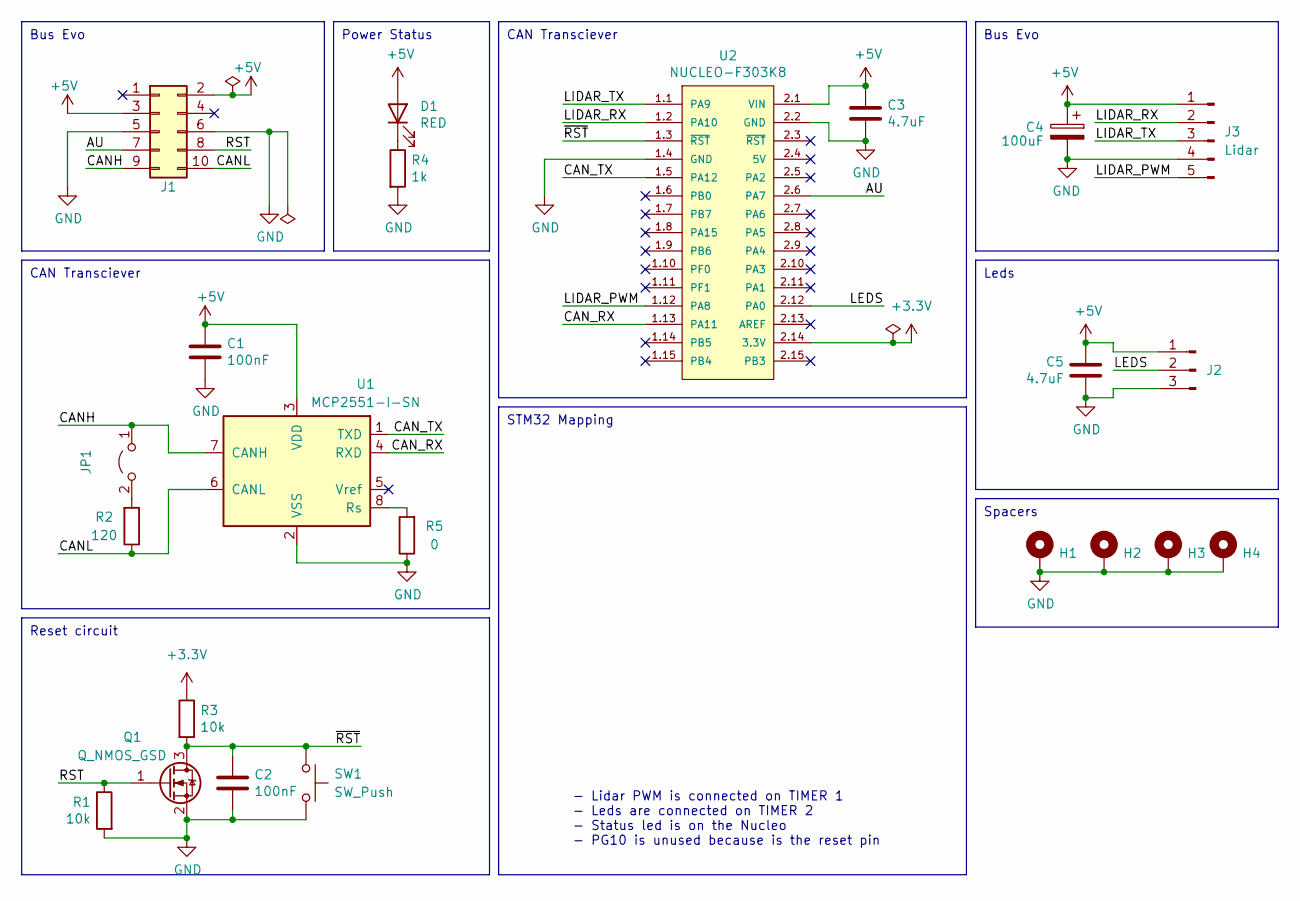
[picture p21: schematic V4.kicad_sch, Carte MDB]

Parts:
C1, C2: 100nF; C_0603_1608Metric
C3, C5: 4.7uF; C_0603_1608Metric
C4: 100uF; C_Elec_6.3x7.7
D1: RED; LED_0805_2012Metric
H1, H2, H3, H4: MountingHole_Pad; WA-SMSI_9774030360
J1: Conn_02x05_Odd_Even; 690367281076
J2: Conn_01x03_Male; B03B-PASK
J3: Lidar; JST_XH_B5B-XH-AM_1x05_P2.50mm_Vertical
JP1: Jumper_2_Open; PinHeader_1x02_P2.54mm_Vertical
Q1: Q_NMOS_GSD; SOT-23
R1, R3: 10k; R_0603_1608Metric
R2: 120; R_0603_1608Metric
R4: 1k; R_0603_1608Metric
R5: 0; R_0603_1608Metric
SW1: SW_Push; SW_Tactile_SPST_Angled_PTS645Vx83-2LFS
U1: MCP2551-I-SN; SOIC-8_3.9x4.9mm_P1.27mm
U2: NUCLEO-F303K8; MODULE_NUCLEO-32

Connections:
+3.3V: R3.1, U2.2.14 (3.3V)
+5V: C1.1, C3.1, C4.1, C5.1, D1.2 (A), J1.2, J1.3, J2.1, J3.1, U1.3 (VDD), U2.2.1 (VIN)
/AU: J1.7, U2.2.6 (PA7)
/CANH: J1.9, JP1.1 (A), U1.7 (CANH)
/CANL: J1.10, R2.1, U1.6 (CANL)
/CAN_RX: U1.4 (RXD), U2.1.13 (PA11)
/CAN_TX: U1.1 (TXD), U2.1.5 (PA12)
/LEDS: J2.2, U2.2.12 (PA0)
/LIDAR_PWM: J3.5, U2.1.12 (PA8)
/LIDAR_RX: J3.2, U2.1.2 (PA10)
/LIDAR_TX: J3.3, U2.1.1 (PA9)
/RST: J1.8, Q1.1 (G), R1.1
/~RST: C2.1, Q1.3 (D), R3.2, SW1.1, U2.1.3 (~RST)
GND: C1.2, C2.2, C3.2, C4.2, C5.2, H1.1, H2.1, H3.1, H4.1, J1.5, J1.6, J2.3, J3.4, Q1.2 (S), R1.2, R4.2, R5.1, SW1.2, U1.2 (VSS), U2.1.4 (GND), U2.2.2 (GND)
unnamed: D1.1 (K), R4.1
unnamed: JP1.2 (B), R2.2
unnamed: R5.2, U1.8 (Rs)

Notes on the sheet:
CAN Transciever
Power Status
Bus Evo
Leds
Spacers
Reset circuit
STM32 Mapping
- Lidar PWM is connected on TIMER 1 - Leds are connected on TIMER 2 - Status led is on the Nucleo - PG10 is unused because is the reset pin

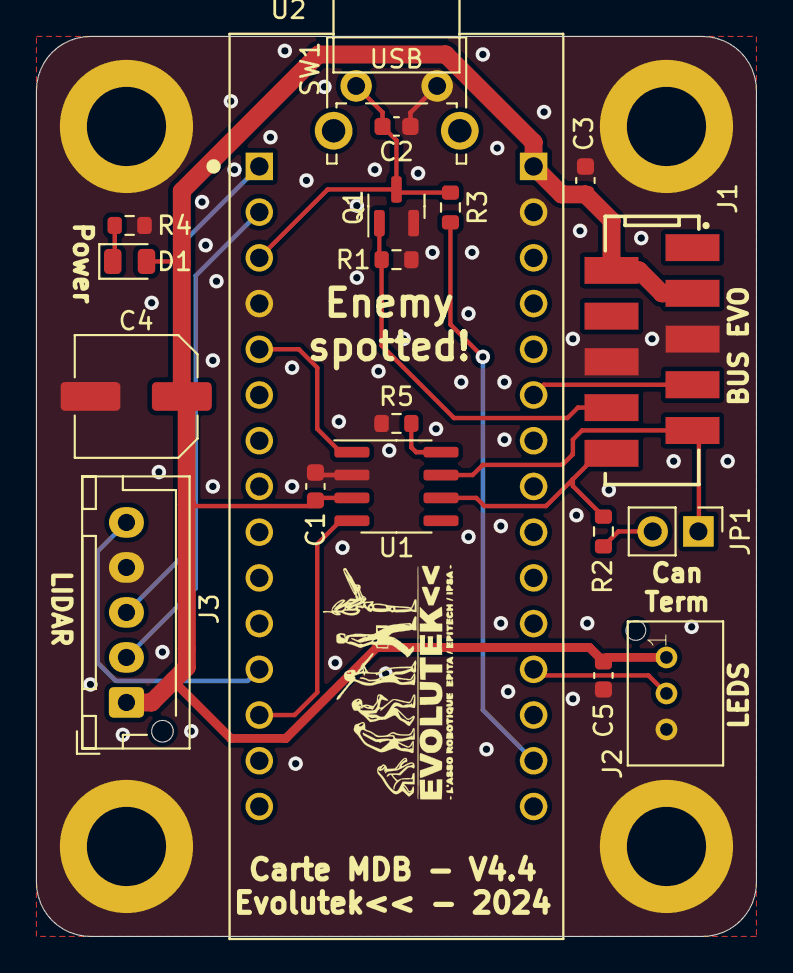
[picture p22: board V4.kicad_pcb from above]

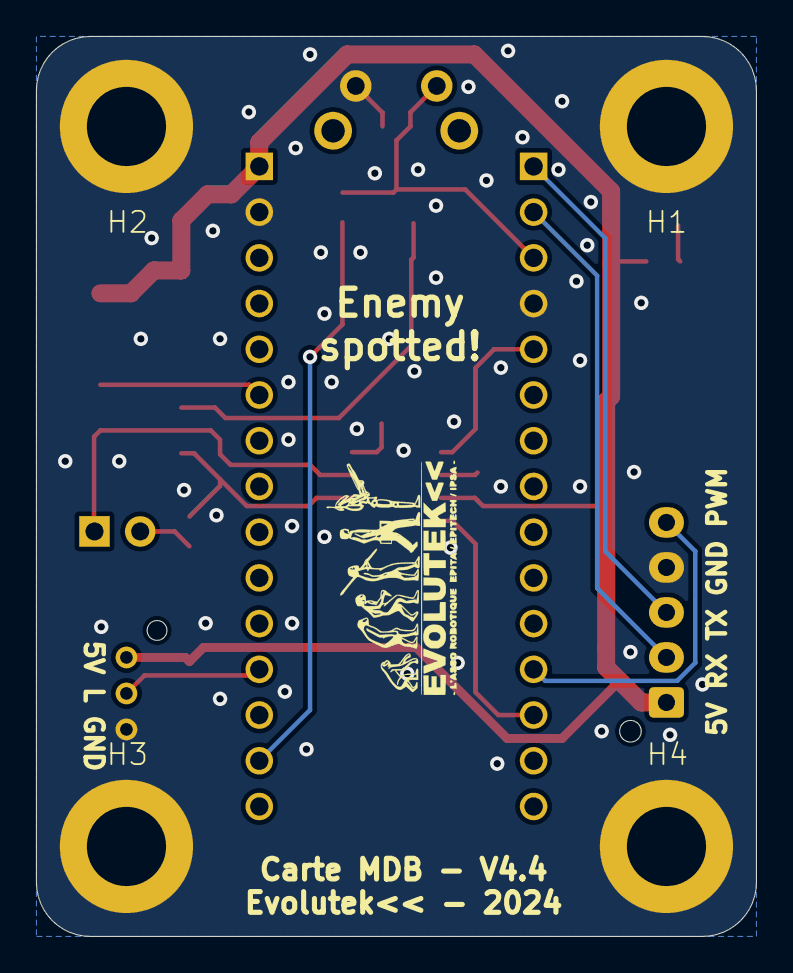
[picture p23: board V4.kicad_pcb from below]

Board: 2 copper layers, 40.0 x 50.0 mm, 24 parts (5 on the bottom side), 17 nets.

Other parts of the board:
Gr: LOGO; logo-evo-min
