evolutek/carte-mat-de-balise/V3/Board.brd

## EAGLE design V3/Board.brd (2020-09-03, an earlier design)

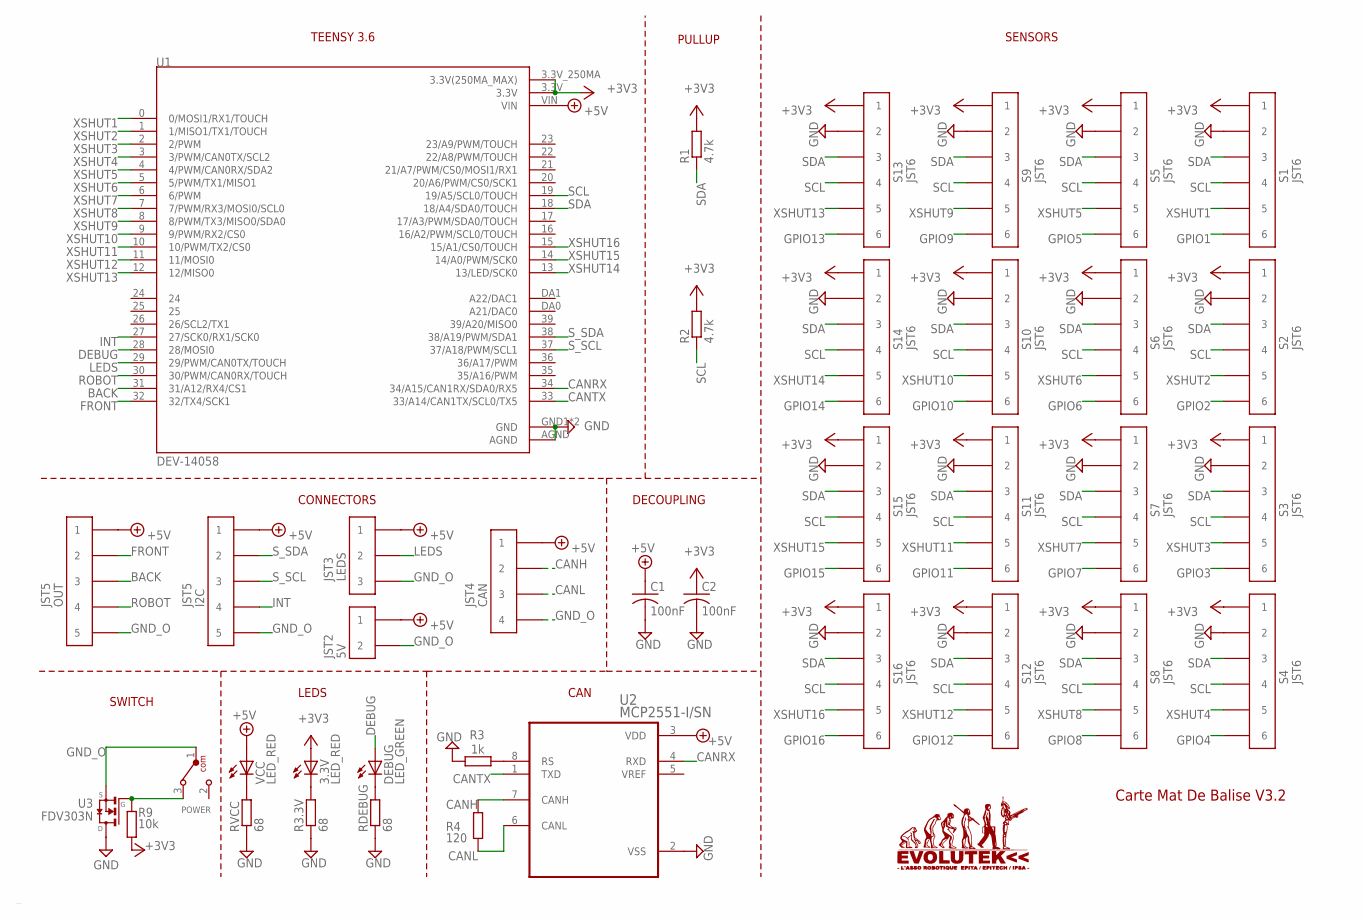
[picture p24: schematic Board.sch]

Parts:
3.3V: LED_RED; CHIPLED_0805
5V: JST2; B02B-PASK
C1, C2: 100nF; C0603
CAN: JST4; B04B-PASK
DEBUG: LED_GREEN; CHIPLED_0805
I2C: JST5; B05B-PASK
LEDS: JST3; B03B-PASK
OUT: JST5; B05B-PASK
POWER: 450302014072
R1, R2: 4.7k; R0603
R3: 1k; R0603
R3.3V: 68; R0603
R4: 120; R0603
R9: 10k; R0603
RDEBUG: 68; R0603
RVCC: 68; R0603
S1, S2, S3, S4, S5, S6, S7, S8, S9, S10, S11, S12, S13, S14, S15, S16: JST6; B06B-PASK
U1: DEV-14058; MODULE_DEV-14058
U2: MCP2551-I/SN; SOIC127P599X175-8N
U3: FDV303N; SOT23
VCC: LED_RED; CHIPLED_0805

Connections:
+3V3: 3.3V.A, C2.1, R1.2, R2.2, R9.2, S1.P$1 (1), S2.P$1 (1), S3.P$1 (1), S4.P$1 (1), S5.P$1 (1), S6.P$1 (1), S7.P$1 (1), S8.P$1 (1), S9.P$1 (1), S10.P$1 (1), S11.P$1 (1), S12.P$1 (1), S13.P$1 (1), S14.P$1 (1), S15.P$1 (1), S16.P$1 (1), U1.3.3V, U1.3.3V_250MA (3.3V(250MA_MAX))
+5V: 5V.P$1 (1), C1.1, CAN.P$1 (1), I2C.P$1 (1), LEDS.P$1 (1), OUT.P$1 (1), U1.VIN, U2.3 (VDD), VCC.A
BACK: OUT.P$3 (3), U1.31 (31/A12/RX4/CS1)
CANH: CAN.P$2 (2), R4.1, U2.7 (CANH)
CANL: CAN.P$3 (3), R4.2, U2.6 (CANL)
CANRX: U1.34 (34/A15/CAN1RX/SDA0/RX5), U2.4 (RXD)
CANTX: U1.33 (33/A14/CAN1TX/SCL0/TX5), U2.1 (TXD)
DEBUG: DEBUG.A, U1.28 (28/MOSI0)
FRONT: OUT.P$2 (2), U1.32 (32/TX4/SCK1)
GND: C1.2, C2.2, R3.2, R3.3V.1, RDEBUG.1, RVCC.1, S1.P$2 (2), S2.P$2 (2), S3.P$2 (2), S4.P$2 (2), S5.P$2 (2), S6.P$2 (2), S7.P$2 (2), S8.P$2 (2), S9.P$2 (2), S10.P$2 (2), S11.P$2 (2), S12.P$2 (2), S13.P$2 (2), S14.P$2 (2), S15.P$2 (2), S16.P$2 (2), U1.AGND, U1.GND1 (GND), U1.GND2 (GND), U2.2 (VSS), U3.3 (D)
GND_O: 5V.P$2 (2), CAN.P$4 (4), I2C.P$5 (5), LEDS.P$3 (3), OUT.P$5 (5), POWER.1, U3.2 (S)
GPIO1: S1.P$6 (6)
GPIO2: S2.P$6 (6)
GPIO3: S3.P$6 (6)
GPIO4: S4.P$6 (6)
GPIO5: S5.P$6 (6)
GPIO6: S6.P$6 (6)
GPIO7: S7.P$6 (6)
GPIO8: S8.P$6 (6)
GPIO9: S9.P$6 (6)
GPIO10: S10.P$6 (6)
GPIO11: S11.P$6 (6)
GPIO12: S12.P$6 (6)
GPIO13: S13.P$6 (6)
GPIO14: S14.P$6 (6)
GPIO15: S15.P$6 (6)
GPIO16: S16.P$6 (6)
INT: I2C.P$4 (4), U1.27 (27/SCK0/RX1/SCK0)
LEDS: LEDS.P$2 (2), U1.29 (29/PWM/CAN0TX/TOUCH)
unnamed: 3.3V.C, R3.3V.2
unnamed: DEBUG.C, RDEBUG.2
unnamed: R3.1, U2.8 (RS)
unnamed: RVCC.2, VCC.C
unnamed: POWER.3, R9.1, U3.1 (G)
ROBOT: OUT.P$4 (4), U1.30 (30/PWM/CAN0RX/TOUCH)
SCL: R2.1, S1.P$4 (4), S2.P$4 (4), S3.P$4 (4), S4.P$4 (4), S5.P$4 (4), S6.P$4 (4), S7.P$4 (4), S8.P$4 (4), S9.P$4 (4), S10.P$4 (4), S11.P$4 (4), S12.P$4 (4), S13.P$4 (4), S14.P$4 (4), S15.P$4 (4), S16.P$4 (4), U1.19 (19/A5/SCL0/TOUCH)
SDA: R1.1, S1.P$3 (3), S2.P$3 (3), S3.P$3 (3), S4.P$3 (3), S5.P$3 (3), S6.P$3 (3), S7.P$3 (3), S8.P$3 (3), S9.P$3 (3), S10.P$3 (3), S11.P$3 (3), S12.P$3 (3), S13.P$3 (3), S14.P$3 (3), S15.P$3 (3), S16.P$3 (3), U1.18 (18/A4/SDA0/TOUCH)
S_SCL: I2C.P$3 (3), U1.37 (37/A18/PWM/SCL1)
S_SDA: I2C.P$2 (2), U1.38 (38/A19/PWM/SDA1)
XSHUT1: S1.P$5 (5), U1.0 (0/MOSI1/RX1/TOUCH)
XSHUT2: S2.P$5 (5), U1.1 (1/MISO1/TX1/TOUCH)
XSHUT3: S3.P$5 (5), U1.2 (2/PWM)
XSHUT4: S4.P$5 (5), U1.3 (3/PWM/CAN0TX/SCL2)
XSHUT5: S5.P$5 (5), U1.4 (4/PWM/CAN0RX/SDA2)
XSHUT6: S6.P$5 (5), U1.5 (5/PWM/TX1/MISO1)
XSHUT7: S7.P$5 (5), U1.6 (6/PWM)
XSHUT8: S8.P$5 (5), U1.7 (7/PWM/RX3/MOSI0/SCL0)
XSHUT9: S9.P$5 (5), U1.8 (8/PWM/TX3/MISO0/SDA0)
XSHUT10: S10.P$5 (5), U1.9 (9/PWM/RX2/CS0)
XSHUT11: S11.P$5 (5), U1.10 (10/PWM/TX2/CS0)
XSHUT12: S12.P$5 (5), U1.11 (11/MOSI0)
XSHUT13: S13.P$5 (5), U1.12 (12/MISO0)
XSHUT14: S14.P$5 (5), U1.13 (13/LED/SCK0)
XSHUT15: S15.P$5 (5), U1.14 (14/A0/PWM/SCK0)
XSHUT16: S16.P$5 (5), U1.15 (15/A1/CS0/TOUCH)

Notes on the sheet:
SENSORS
TEENSY 3.6
CONNECTORS
SWITCH
DECOUPLING
LEDS
PULLUP
CAN
C:/Users/coren/Documents/MEGA/logo_evo.bmp
Carte Mat De Balise V3.2

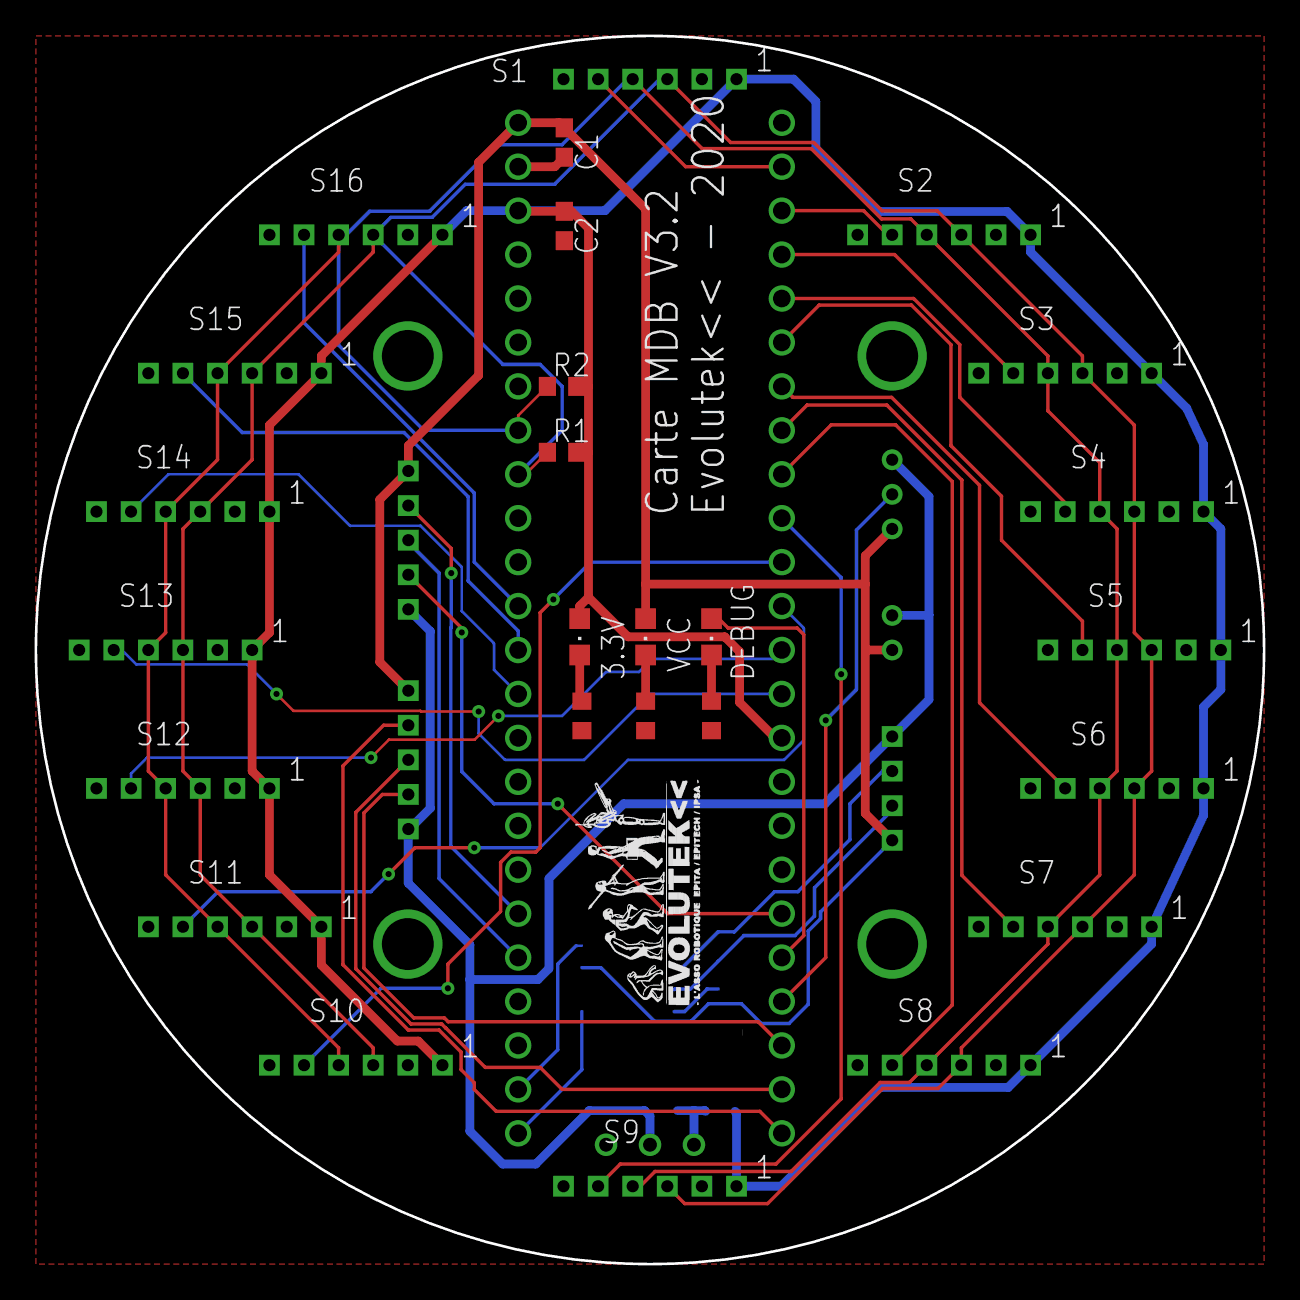
[picture p25: board V3/Board.brd from above]

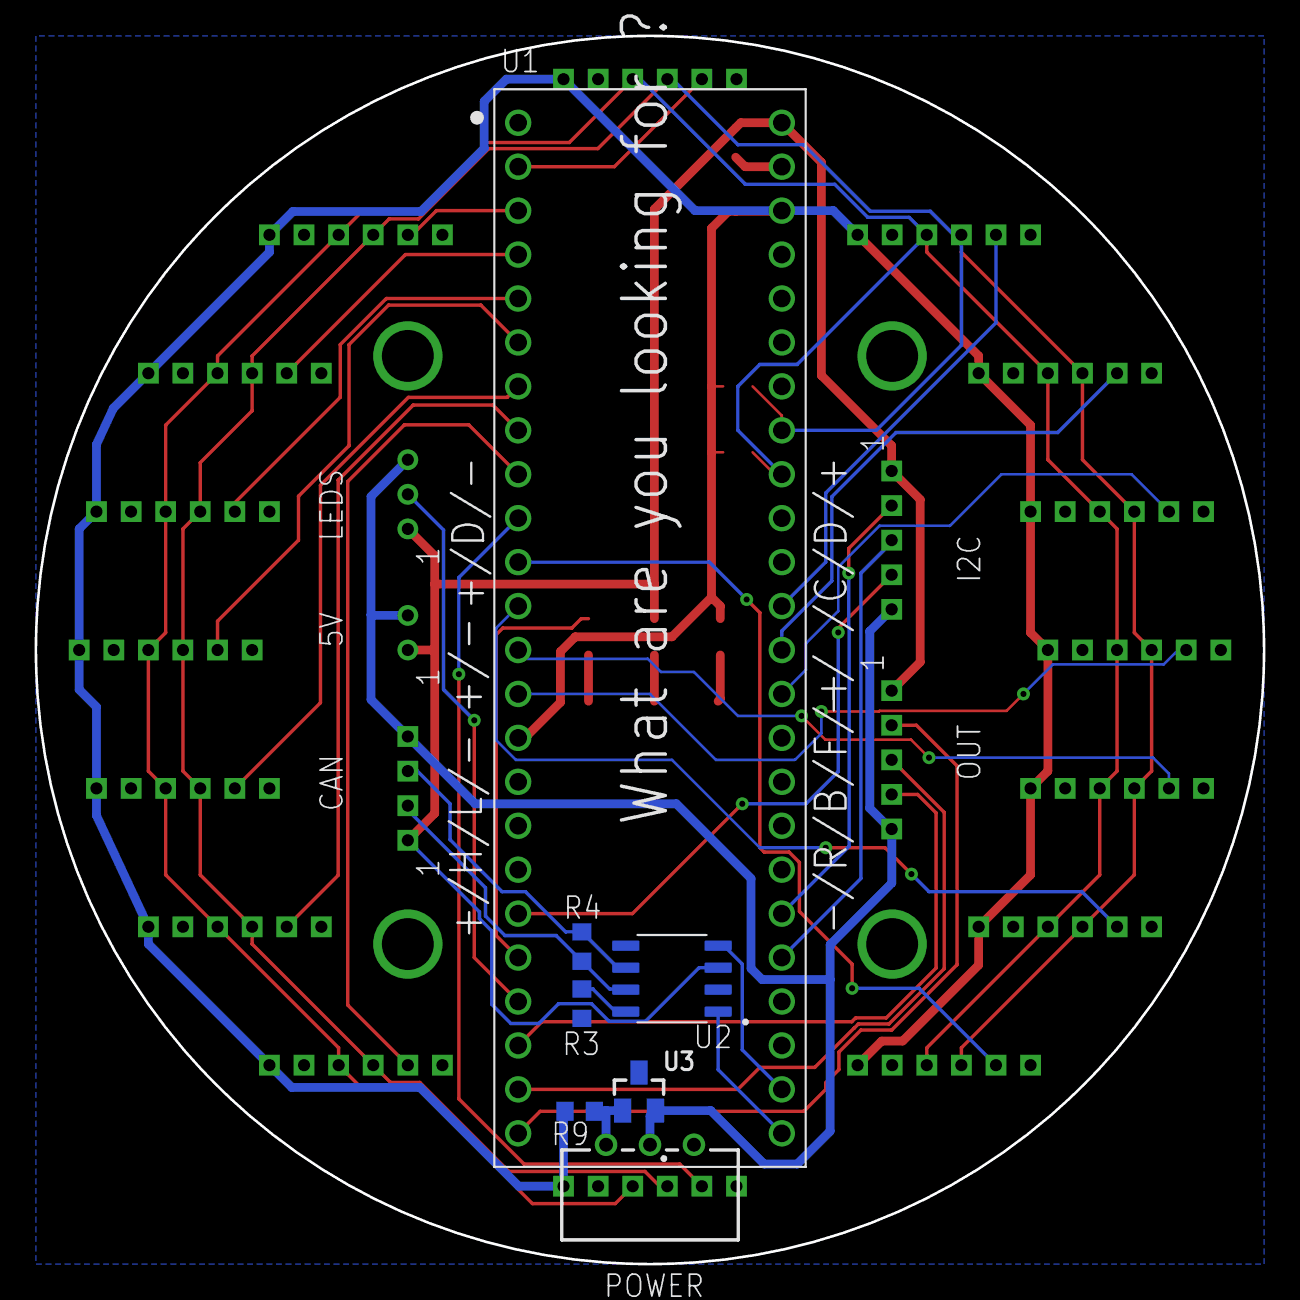
[picture p26: board V3/Board.brd from below]

Board: 2 copper layers, 71.0 x 71.0 mm, 38 parts (12 on the bottom side), 39 nets.
