evolutek/carte-mat-de-balise/V2/Board.brd

## EAGLE design V2/Board.brd (2020-03-29, an earlier design)

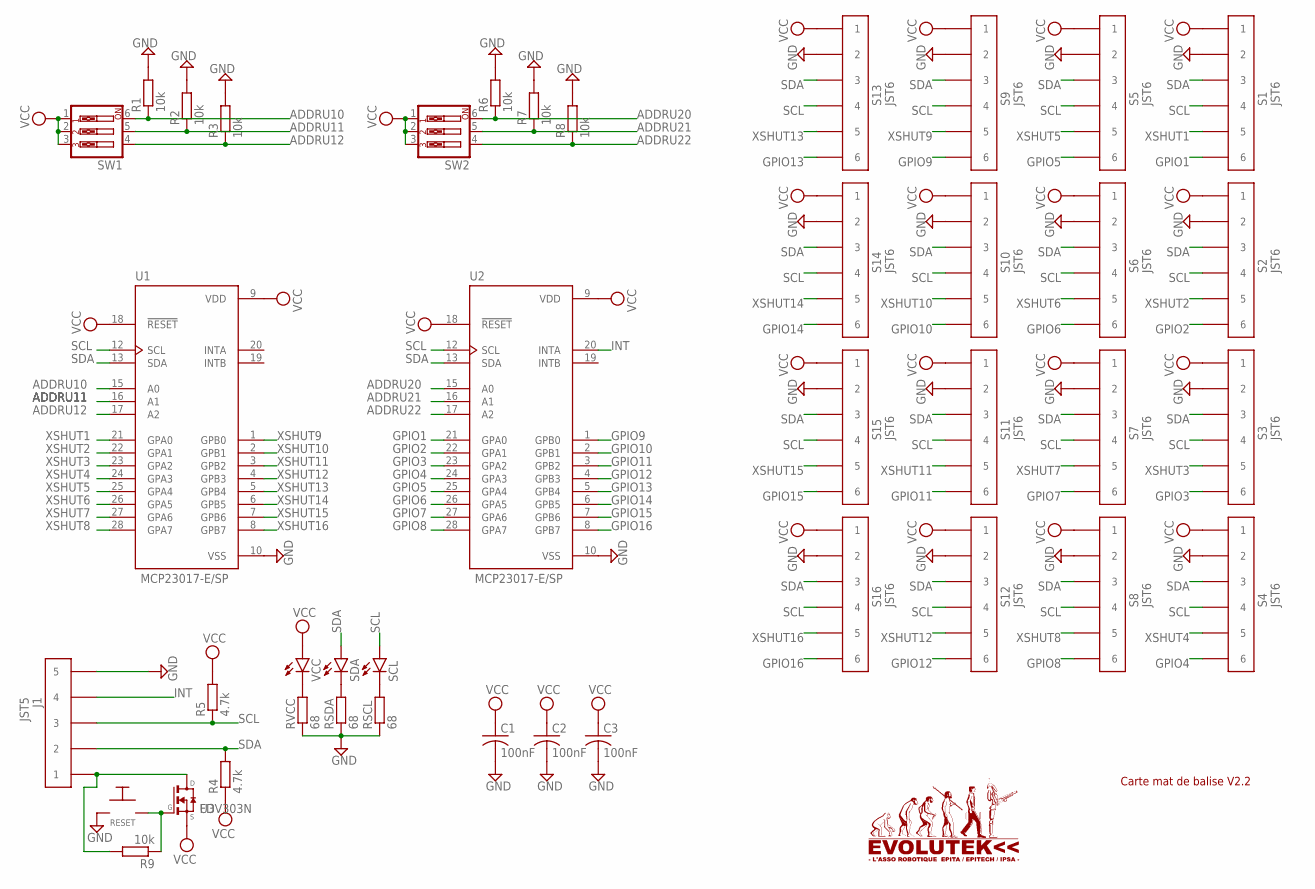
[picture p27: schematic Board.sch]

Parts:
C1, C2, C3: 100nF; C0603
J1: JST5; B05B-PASK
R1, R2, R3, R6, R7, R8, R9: 10k; R0603
R4, R5: 4.7k; R0603
RESET: 1825095-3
RSCL: 68; R0603
RSDA: 68; R0603
RVCC: 68; R0603
S1, S2, S3, S4, S5, S6, S7, S8, S9, S10, S11, S12, S13, S14, S15, S16: JST6; B06B-PASK
SCL: LEDCHIPLED_0805; CHIPLED_0805
SDA: LEDCHIPLED_0805; CHIPLED_0805
SW1, SW2: SW_DIP-3; EDG-03
U1, U2: MCP23017-E/SP; DIP787W45P254L3556H508Q28
U3: FDV303N; SOT23
VCC: LEDCHIPLED_0805; CHIPLED_0805

Connections:
ADDRU10: R1.1, SW1.6, U1.15 (A0)
ADDRU11: R2.1, SW1.5, U1.16 (A1)
ADDRU12: R3.1, SW1.4, U1.17 (A2)
ADDRU20: R6.1, SW2.6, U2.15 (A0)
ADDRU21: R7.1, SW2.5, U2.16 (A1)
ADDRU22: R8.1, SW2.4, U2.17 (A2)
GND: C1.2, C2.2, C3.2, J1.P$5 (5), R1.2, R2.2, R3.2, R6.2, R7.2, R8.2, RESET.P$3, RSCL.1, RSDA.1, RVCC.1, S1.P$2 (2), S2.P$2 (2), S3.P$2 (2), S4.P$2 (2), S5.P$2 (2), S6.P$2 (2), S7.P$2 (2), S8.P$2 (2), S9.P$2 (2), S10.P$2 (2), S11.P$2 (2), S12.P$2 (2), S13.P$2 (2), S14.P$2 (2), S15.P$2 (2), S16.P$2 (2), U1.10 (VSS), U2.10 (VSS)
GPIO1: S1.P$6 (6), U2.21 (GPA0)
GPIO2: S2.P$6 (6), U2.22 (GPA1)
GPIO3: S3.P$6 (6), U2.23 (GPA2)
GPIO4: S4.P$6 (6), U2.24 (GPA3)
GPIO5: S5.P$6 (6), U2.25 (GPA4)
GPIO6: S6.P$6 (6), U2.26 (GPA5)
GPIO7: S7.P$6 (6), U2.27 (GPA6)
GPIO8: S8.P$6 (6), U2.28 (GPA7)
GPIO9: S9.P$6 (6), U2.1 (GPB0)
GPIO10: S10.P$6 (6), U2.2 (GPB1)
GPIO11: S11.P$6 (6), U2.3 (GPB2)
GPIO12: S12.P$6 (6), U2.4 (GPB3)
GPIO13: S13.P$6 (6), U2.5 (GPB4)
GPIO14: S14.P$6 (6), U2.6 (GPB5)
GPIO15: S15.P$6 (6), U2.7 (GPB6)
GPIO16: S16.P$6 (6), U2.8 (GPB7)
INT: J1.P$4 (4), U2.20 (INTA)
unnamed: R9.1, RESET.P$1, U3.1 (G)
unnamed: J1.P$1 (1), R9.2, U3.3 (D)
unnamed: RSDA.2, SDA.C
unnamed: RSCL.2, SCL.C
unnamed: RVCC.2, VCC.C
SCL: J1.P$3 (3), R5.1, S1.P$4 (4), S2.P$4 (4), S3.P$4 (4), S4.P$4 (4), S5.P$4 (4), S6.P$4 (4), S7.P$4 (4), S8.P$4 (4), S9.P$4 (4), S10.P$4 (4), S11.P$4 (4), S12.P$4 (4), S13.P$4 (4), S14.P$4 (4), S15.P$4 (4), S16.P$4 (4), SCL.A, U1.12 (SCL), U2.12 (SCL)
SDA: J1.P$2 (2), R4.2, S1.P$3 (3), S2.P$3 (3), S3.P$3 (3), S4.P$3 (3), S5.P$3 (3), S6.P$3 (3), S7.P$3 (3), S8.P$3 (3), S9.P$3 (3), S10.P$3 (3), S11.P$3 (3), S12.P$3 (3), S13.P$3 (3), S14.P$3 (3), S15.P$3 (3), S16.P$3 (3), SDA.A, U1.13 (SDA), U2.13 (SDA)
VCC: C1.1, C2.1, C3.1, R4.1, R5.2, S1.P$1 (1), S2.P$1 (1), S3.P$1 (1), S4.P$1 (1), S5.P$1 (1), S6.P$1 (1), S7.P$1 (1), S8.P$1 (1), S9.P$1 (1), S10.P$1 (1), S11.P$1 (1), S12.P$1 (1), S13.P$1 (1), S14.P$1 (1), S15.P$1 (1), S16.P$1 (1), SW1.1, SW1.2, SW1.3, SW2.1, SW2.2, SW2.3, U1.9 (VDD), U1.18 (!RESET), U2.9 (VDD), U2.18 (!RESET), U3.2 (S), VCC.A
XSHUT1: S1.P$5 (5), U1.21 (GPA0)
XSHUT2: S2.P$5 (5), U1.22 (GPA1)
XSHUT3: S3.P$5 (5), U1.23 (GPA2)
XSHUT4: S4.P$5 (5), U1.24 (GPA3)
XSHUT5: S5.P$5 (5), U1.25 (GPA4)
XSHUT6: S6.P$5 (5), U1.26 (GPA5)
XSHUT7: S7.P$5 (5), U1.27 (GPA6)
XSHUT8: S8.P$5 (5), U1.28 (GPA7)
XSHUT9: S9.P$5 (5), U1.1 (GPB0)
XSHUT10: S10.P$5 (5), U1.2 (GPB1)
XSHUT11: S11.P$5 (5), U1.3 (GPB2)
XSHUT12: S12.P$5 (5), U1.4 (GPB3)
XSHUT13: S13.P$5 (5), U1.5 (GPB4)
XSHUT14: S14.P$5 (5), U1.6 (GPB5)
XSHUT15: S15.P$5 (5), U1.7 (GPB6)
XSHUT16: S16.P$5 (5), U1.8 (GPB7)

Notes on the sheet:
Carte mat de balise V2.2

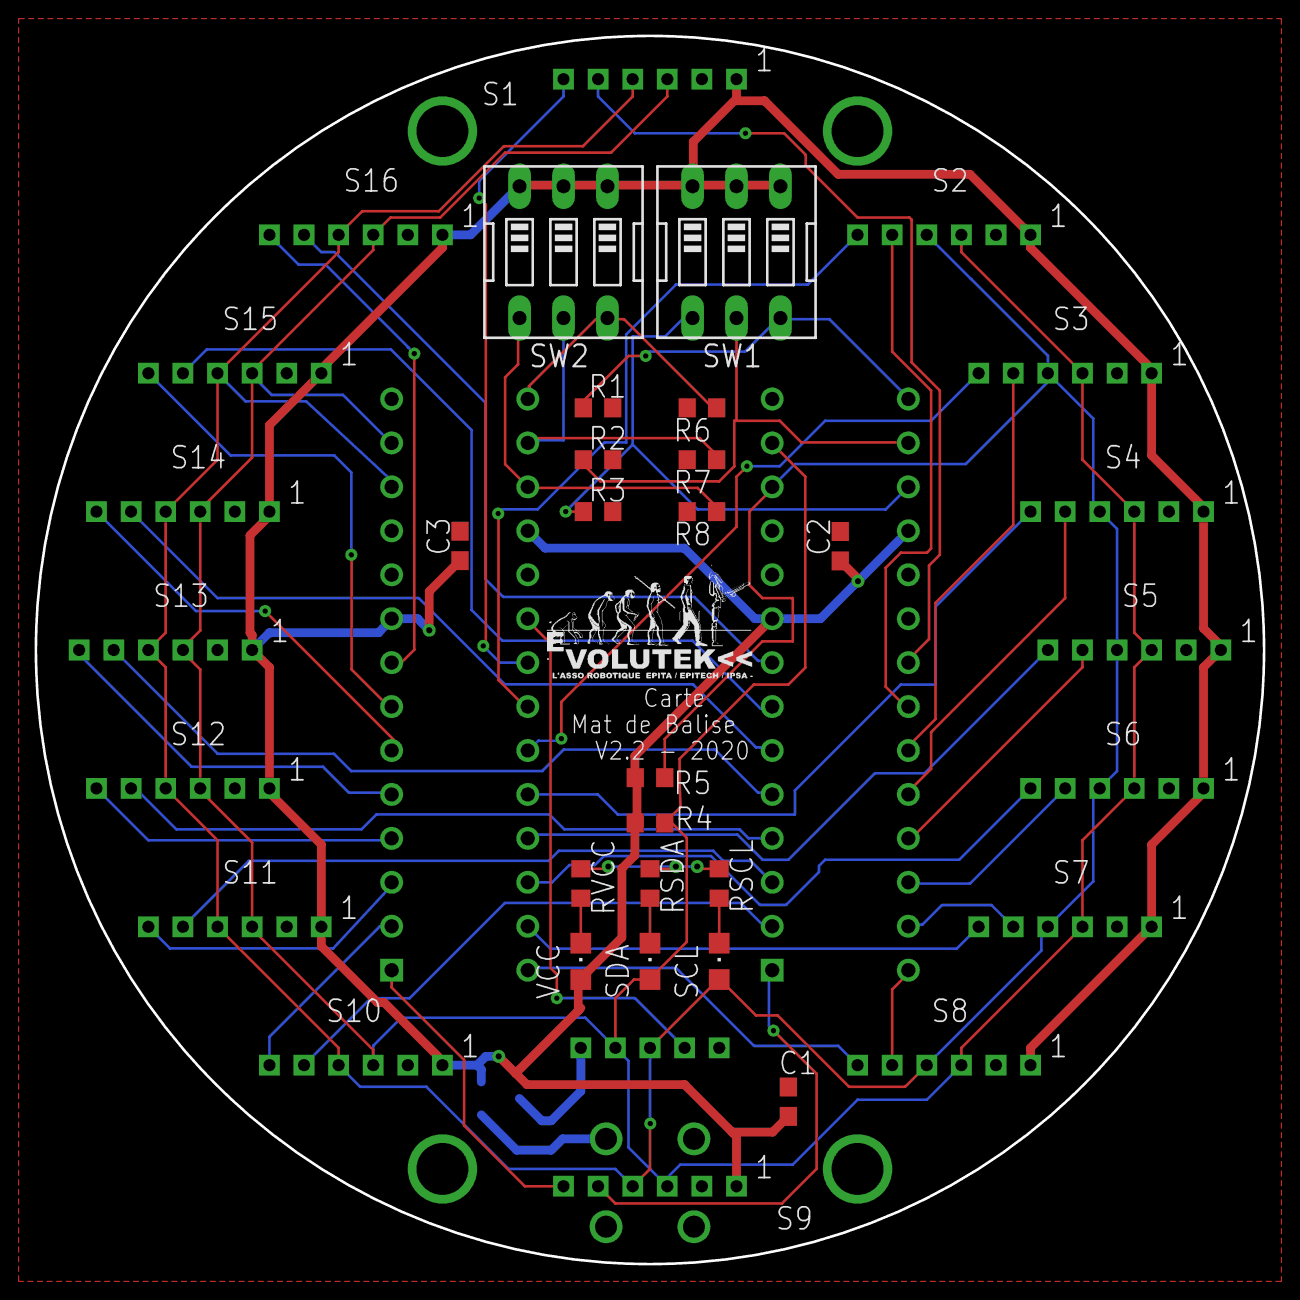
[picture p28: board V2/Board.brd from above]

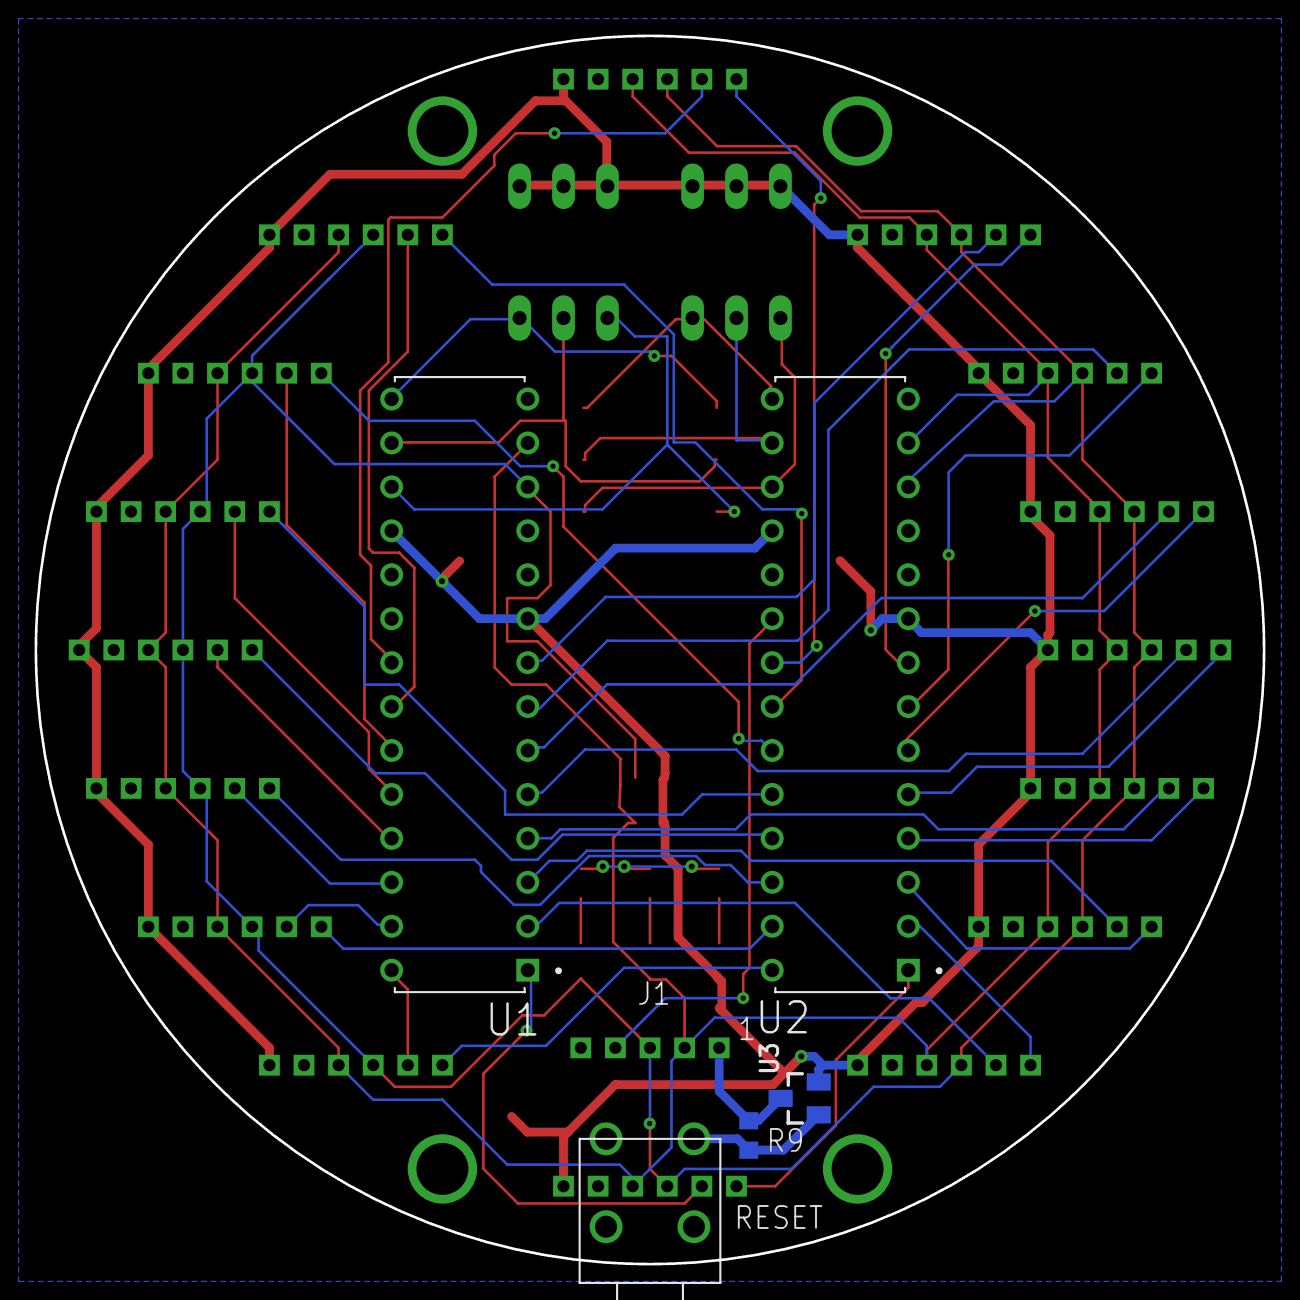
[picture p29: board V2/Board.brd from below]

Board: 2 copper layers, 71.0 x 71.0 mm, 41 parts (6 on the bottom side), 48 nets.
