evolutek/carte-mat-de-balise/V5/carte-mdb-v5.ioc

Mcu.UserName=STM32G491KEUx
PA0.GPIO_Label=LEDS
PA0.Signal=S_TIM2_CH1
PA1.GPIO_Label=AU
PA1.Signal=GPIO_Input
PA10.GPIO_Label=LIDAR_RX
PA10.Signal=USART1_RX
PA11.GPIO_Label=USB_D-
PA11.Signal=USB_DM
PA12.GPIO_Label=USB_D+
PA12.Signal=USB_DP
PA13.GPIO_Label=SWDIO
PA13.Signal=SYS_JTMS-SWDIO
PA14.GPIO_Label=SWCLK
PA14.Signal=SYS_JTCK-SWCLK
PA15.GPIO_Label=LIDAR_SELECT
PA15.Signal=GPIO_Input
PA2.GPIO_Label=VCP_TX
PA2.Signal=USART2_TX
PA3.GPIO_Label=VCP_RX
PA3.Signal=USART2_RX
PA4.Signal=SPI1_NSS
PA5.Signal=SPI1_SCK
PA6.Signal=SPI1_MISO
PA7.Signal=SPI1_MOSI
PA8.GPIO_Label=LIDAR_PWM
PA8.Signal=S_TIM1_CH1
PA9.GPIO_Label=LIDAR_TX
PA9.Signal=USART1_TX
PB0.GPIO_Label=CD
PB0.Signal=GPIO_Input
PB3.GPIO_Label=SWO
PB3.Signal=SYS_JTDO-SWO
PB4.GPIO_Label=STATUS
PB4.Signal=GPIO_Output
PB5.GPIO_Label=CAN_RX
PB5.Signal=FDCAN2_RX
PB6.GPIO_Label=CAN_TX
PB6.Signal=FDCAN2_TX
PB7.GPIO_Label=LIDAR_LED
PB7.Signal=S_TIM3_CH4
