evolutek/carte-mat-de-balise/STM32/Mdb/Core/Inc/main.h

#define MCO_Pin GPIO_PIN_0
#define MCO_GPIO_Port GPIOF
#define BAU_Pin GPIO_PIN_1
#define BAU_GPIO_Port GPIOF
#define MCTL_Pin GPIO_PIN_6
#define MCTL_GPIO_Port GPIOA
#define LEDS_Pin GPIO_PIN_7
#define LEDS_GPIO_Port GPIOA
#define SWDIO_Pin GPIO_PIN_13
#define SWDIO_GPIO_Port GPIOA
#define SWCLK_Pin GPIO_PIN_14
#define SWCLK_GPIO_Port GPIOA
