evolutek/carte-mat-de-balise/Arduino/NSensors-mcp23017-continuous/NSensors-mcp23017-continuous.ino

#include <Wire.h>
#include <VL53L0X.h>
#include <FastLED.h>
#include "Adafruit_MCP23017.h"

#define BRIGHTNESS      128
#define COLOR_ORDER     RGB
#define LED_PIN         36
#define LED_TYPE        WS2812
#define MAX_DIST        500
#define NB_SENSORS      16
#define REFRESH         100 
#define SENSOR_ADDR     0x29

#define MCP23017_XSHUT_ADDR 0
#define MCP23017_GPIO_ADDR 0

float   coef = 255.0 / (MAX_DIST / 2);
CRGB    leds[NB_SENSORS];
VL53L0X sensors[NB_SENSORS];

Adafruit_MCP23017 mcp_xshut;
Adafruit_MCP23017 mcp_gpio;

void setup() {

  // Init Led strip
  FastLED.addLeds<LED_TYPE, LED_PIN, GRB>(leds, NB_SENSORS);
  FastLED.setBrightness(BRIGHTNESS);

  Serial.begin(9600);
  Wire.setClock(400000);
  Wire.begin();

  // Init mcp23017 xshut
  Serial.println("Init MCP");
  mcp_xshut.begin();

  // Set every pin to output
  for (int i = 0; i < 15; ++i)
  {
    mcp_xshut.pinMode(i, OUTPUT);
    mcp_xshut.digitalWrite(i, LOW);
  }

  // Init sensors
  for (int i = NB_SENSORS -1; i >= 0; i--) {
    mcp_xshut.digitalWrite(i, HIGH);
    init_sensor(i);
  }

}

void init_sensor(int i) {
  Serial.print("Init sensor nb: ");
  Serial.println(i + 1);
  sensors[i].init();
  sensors[i].setTimeout(500);
  sensors[i].setAddress(SENSOR_ADDR + i);
  sensors[i].setSignalRateLimit(0.1);
  sensors[i].setVcselPulsePeriod(VL53L0X::VcselPeriodPreRange, 18);
  sensors[i].setVcselPulsePeriod(VL53L0X::VcselPeriodFinalRange, 14);
  sensors[i].startContinuous();
}

void loop() {
  Serial.print("---- STARTING SCAN -----\n");

  int start = millis();

  for (int i = 0; i < NB_SENSORS; i++) {
    Serial.print("Sensor nb : ");
    Serial.print(i + 1);
    Serial.print(" dist :");

    int dist = sensors[i].readRangeContinuousMillimeters();

    Serial.print(dist);

    if (sensors[i].timeoutOccurred())
      Serial.print(" TIMEOUT");
    Serial.println();

    if (dist > MAX_DIST)
      leds[i] = CRGB::Black;
    else {
      int r = 255 - dist * coef;
      int g = 255 - abs(MAX_DIST / 2 - dist) * coef;
      int b = 255 - (MAX_DIST - dist) * coef;
      leds[i].red = r >= 0 ? r : 0;
      leds[i].green = g >= 0 ? g : 0;
      leds[i].blue = b >= 0 ? b : 0;
    }
  }

  Serial.print("---- END SCAN -----\n");
  Serial.print("Ellipsed time: ");
  Serial.println(millis() - start);
 
  FastLED.show();
  delay(REFRESH);

}
