evolutek/carte-mat-de-balise/Arduino/ControlLed/ControlLed.ino

#include <FastLED.h>

#define LED_PIN     5
#define NUM_LEDS    3
#define UPDATES_PER_SECOND 100
#define BRIGHTNESS  12
#define LED_TYPE    WS2812
#define COLOR_ORDER RGB
CRGB leds[NUM_LEDS];

void setup() {
    delay(2000);
    FastLED.addLeds<LED_TYPE, LED_PIN, GRB>(leds, NUM_LEDS);
    FastLED.setBrightness(BRIGHTNESS);

}

void loop() {
  // put your main code here, to run repeatedly:
  leds[0] = CRGB::Red;
  leds[1] = CRGB::Green;
  leds[2] = CRGB::Blue;
  FastLED.show();
  delay(500);
  // Now turn the LED off, then pause
  leds[0] = CRGB::Black;
  leds[1] = CRGB::Black;
  leds[2] = CRGB::Black;
  FastLED.show();
  delay(500);
}
