evolutek/carte-mat-de-balise/(commit log)

2019-06-30 Add V1 schematics
    [Board.brd, Board.sch]
2019-07-02 Complete design
    [Board.brd, Board.sch]
2019-08-31 Update Res value
    [Board.sch]
2019-09-12 Re-route properly the board
    [Board.brd, Board.step]
2019-09-13 Add Arduino test code
2019-09-16 Add code to control leds
2019-09-16 Control leds with sensors
2019-09-16 Correct board size and prepare to be route
    [Board.brd, Board.sch]
2019-09-16 V1 routed
    [Board.brd, BoardV1.step]
2019-09-16 Add code to use N sensors with leds
2019-09-17 Change board size and add BOM
    [BOM CarteMatDeBalise.xlsx, Board.brd, BoardV1.step]
2019-09-24 Make code init each sensors with xshut pin
2020-01-18 Add schematic for V2, change to MCP23017
    [Board.brd, Board.sch, Board.step, BoardV1.step]
2020-01-18 Add NSensors with support for mcp23017 xshut only (no interrupt)
2020-01-18 [V2] Add schematic and gerber pdf
2020-01-19 [V2] Release with two Gpio Expander
    [Board.brd, Board.sch]
2020-01-24 Standarized resistance value and fix power symbol
    [Board.brd, Board.sch]
2020-01-24 Update schematic pdf
2020-01-24 [V.2] Release
    [Board.brd, Board.sch]
2020-01-25 [V2.0] Change MCP placement
    [Board.brd, Board.sch]
2020-03-02 [V2.1] Routes RESET on VCC and add a capacitor
    [Board.brd, Board.sch, Board.step, BoardV1.step]
2020-03-29 [V2.2] Realase V2.2 with a RESET Button
    [Board.brd, Board.sch, Board.step]
2020-04-25 Update Arduino code
2020-08-20 Add V3.0
    [Board.brd, Board.sch]
2020-08-20 WIP teensy
2020-08-21 [V3.0] Release V3.0 with a teensy
    [Board.brd]
2020-08-23 Add Teensy code for MDB with basi communication
2020-08-24 MDB Teensy i2c communication
2020-09-01 MDB Teensy
2020-09-01 Setup now checks all sensors
2020-09-03 [V3.2] Release V3.2
    [Board.brd, Board.sch]
2020-09-15 Teensy now defaults to error to detect I2C problems
    [Teensy-MDB.ino]
2020-10-05 Fixed MDB sensors initialisation problem + Waiting mode
    [Teensy-MDB.ino]
2020-10-09 Small fixes TeensyMDB
2020-10-18 Teensy code improvements
2020-10-21 Error mode blinks in red
    [Teensy-MDB.ino]
2020-10-22 Coefs on sensors to trigger avoid
    [Teensy-MDB.ino]
2020-12-08 Add V4
    [V4.kicad_pcb, V4.sch]
2021-02-14 V4.1: Removed switch and deco 5V nucleo
    [V4.kicad_pcb, V4.sch]
2021-02-19 The Nucleo can control the Lidar :)
2021-02-19 Oops failed to push correctly
    [Mdb.ioc, main.c]
2021-02-24 Graphics fixes
    [V4.kicad_pcb]
2021-02-27 Testing Lidar communication from Nucleo
2021-04-27 Not working POC for Lidar on STM32
    [main.c]
2021-12-07 Update V4 board Bus Evo
    [V4.kicad_pcb, V4.sch]
2023-03-07 Wip V4.3
    [V4.kicad_sch, V4.sch]
2023-03-08 Release V4.3
    [V4.kicad_pcb]
2024-01-06 Carte MDB V4.4
    [V4.kicad_pcb, V4.kicad_sch]
2024-01-22 Replace smd spacer
    [V4.kicad_pcb, V4.kicad_sch]
2024-10-25 Add Carte Led V1.0
    [carte-led.kicad_pcb, carte-led.kicad_sch, carte-led.step]
2024-10-29 WIP V5
    [BOM CarteMatDeBalise.xlsx, V5.kicad_pcb, V5.kicad_sch]
2024-11-04 Release V5.0
    [V5.kicad_pcb, V5.kicad_sch]
2024-11-14 Minor fixes
    [V5.kicad_pcb, V5.kicad_sch]
2025-01-02 Add CAN ID label
    [V5.kicad_pcb, V5.kicad_sch]
